Alexandr-Filatov/Storage_Armature_MCU_PCB/BOM/Storage_Armature_MCU_PCB_BOM_08.07.2026_EN.xlsx

Reference | Value | Product Name | Replacement | Package | Description | Quantity | DNP
C1, C2, C4, C6, C8, C9, C12, C13, C19, C22, C25, C28, C33, C37, C40, C43, C50, C54, C57, C59, C63, C65, C70, C75, C77, C81, C88, C90, C94, C97, C99, C103, C109, C110, C111, C112, C113 | 100n |  |  | SMD 0805 | Capacitor SMD 50V | 37
C48, C108 | 100n |  |  | SMD 1206 | Capacitor SMD 50V | 2
C3, C5, C7, C16, C31, C39, C49, C52, C53, C61, C62, C79, C80, C82, C83, C84, C85, C92, C93, C101, C102, C106 | 10n |  |  | SMD 0805 | Capacitor SMD 50V | 22
C34, C35, C44, C45, C47, C66, C74, C107 | 10u |  |  | SMD 1206 | Capacitor SMD 50V | 8
C26, C30 | 12p |  |  | SMD 0805 | Capacitor SMD 50V | 2
C15 | 1u |  |  | SMD 0805 | Capacitor SMD 50V | 1
C105 | 2.2n |  |  | SMD 1812 | Capacitor SMD 50V | 1
C18, C20, C21, C23, C24, C29, C32, C38, C42, C51, C56, C60, C72, C78, C87, C91, C96, C100 | 2.2u |  |  | SMD 0805 | Capacitor SMD 50V | 18
C17, C27, C36, C46, C58, C76, C89, C98 | 22n |  |  | SMD 0805 | Capacitor SMD 50V | 8
C67 | 330u | EEUFR1H331L |  | CP Radial D10.0mm P5.00mm | Polarized capacitor | 1
C14 | 4.7u |  |  | SMD 0805 | Capacitor SMD 50V | 1
C68, C69, C71, C73 | 4.7u |  |  | SMD 1206 | Capacitor SMD 50V | 4
C10, C11, C41, C55, C64, C86, C95, C104 | 56p |  |  | SMD 0805 | Capacitor SMD 50V | 8
D1 | ~ | B2405S-1WR3 |  | S-1WR3 | DC/DC | 1
D58, D61, D64, D67 | ~ | RS1B |  | SMA | Fast recovery diode | 4
D10 | ~ | SMCJ33A |  | SMC | Supressor | 1
D7, D17 | ~ | FYLS-0805UBC |  | SMD 0805 | Blue LED | 2
D11, D19, D22, D23, D57, D60, D63, D66, D68, D69, D70, D71 | ~ | FYLS-0805UYC |  | SMD 0805 | Yellow LED | 12
D24, D25, D26 | ~ | FYLS-1206UBC |  | SMD 1206 | Blue LED | 3
D20 | ~ | BZT52C10 |  | SOD-123 | Zener_Diode | 1
D5 | ~ | LBAT54HT1G |  | SOD-323 | Diode | 1
D14 | ~ | SM24CANB-02HTG |  | SOT-23 | Dual Line CAN Bus Protector, 24Vrwm | 1
D21 | ~ | SM712 |  | SOT-23 | ESD Diode | 1
D2, D3, D4, D6, D8, D13, D15, D16, D56, D59, D62, D65 | ~ | BAT54S |  | SOT-23 | Schottky barrier diode | 12
D18 | ~ | TD301D485H-A |  | TD301D485H-AB | RS485 Transciever | 1
D12 | ~ | TD301MCANFD |  | TD5(3)01MCANFD | CAN Transceiver | 1
D9 | ~ | WRB2405S-3WR2 |  | WRB S-3WR2 | DC/DC | 1
F1, F4, F5, F6 | ~ | MF-SM075/60-2 |  | Fuse Bourns MF-SM 7.98x5.44mm | Fuse SMD | 4
F3 | ~ | MF-MSMF020 |  | SMD 1812 | Fuse SMD | 1
F2 | ~ | MF-MSMF050/30X-2 |  | SMD 1812 | Fuse SMD | 1
J24, J25, J26, J27, J28, J29, J30, J31, J32, J33 | ~ | DS1073-01-2x1MR2T6 |  | Molex Mini-Fit Jr 5569-02A2 2x01 P4.20mm | Connector | 10
J6, J7, J8, J34, J35, J38, J39 | ~ | DS1073-01-2x2MR3T6 |  | Molex Mini-Fit Jr 5569-04A2 2x02 P4.20mm | Connector | 7
J2 | ~ | DS1073-01-2x3MR2T6 |  | Molex Mini-Fit Jr 5569-06A2 2x03 P4.20mm | Connector | 1
J1 | ~ | DS-1021-1x4 | KLS1-207-1-04-S | PinHeader 1x04 P2.54mm | Connector | 1
J3 | ~ | DS1021-2x8 | KLS1-207-2-16-S | PinHeader 2x08 P2.54mm | Connector | 1
JP1, JP2, JP3, JP4, JP5, JP6, JP7 | ~ | DS1027-2ABN0 |  | PinHeader 1x02 P2.54mm | Jumper | 7
L2, L3 | 6.8u | LQH32CN6R8M53L |  | SMD 1210 | Inductor SMD | 2
L1, L4 | ~ | ACM2520-301-2P-T002 |  | CommonModeChoke TDK ACM2520-2P | Inductor SMD | 2
Q10, Q11, Q12, Q13 | ~ | 2N7002 |  | SOT-23 | N_channel MOSFET | 4
Q1, Q2 | ~ | 20N06 |  | TO-252-2 | N_channel MOSFET | 2
R79, R80, R81, R82, R83, R84, R85, R86 | 0 |  |  | SMD 1206 | Resistor SMD 1% | 8
R3, R4, R18, R28, R36, R50, R62, R70 | 10 |  |  | SMD 1206 | Resistor SMD 0.1% | 8
R7, R9, R12, R13, R19, R20, R29, R30, R38, R41, R51, R52, R63, R64, R71, R72 | 100 |  |  | SMD 0805 | Resistor SMD 1% | 16
R55 | 100k |  |  | SMD 0805 | Resistor SMD 1% | 1
R1, R2, R8, R11, R14, R15, R23, R24, R31, R32, R42, R43, R53, R56, R65, R66, R73, R74, R90, R91, R93, R96, R97, R110, R113, R116, R119 | 10k |  |  | SMD 0805 | Resistor SMD 1% | 27
R10, R17, R27, R35, R46, R61, R69, R77 | 120 |  |  | SMD 0805 | Resistor SMD 1% | 8
R49 | 1M |  |  | SMD 2512 | Resistor SMD 1% | 1
R6, R39, R57, R58, R87, R108, R111, R114, R117, R120, R121, R122, R123 | 1k |  |  | SMD 0805 | Resistor SMD 1% | 13
R47, R48 | 20 |  |  | SMD 0805 | Resistor SMD 1% | 2
R5, R16, R21, R22, R25, R26, R33, R34, R44, R45, R59, R60, R67, R68, R75, R76 | 20k |  |  | SMD 0805 | Resistor SMD 1% | 16
R92, R94, R95 | 3.3k |  |  | SMD 1206 | Resistor SMD 1% | 3
R54, R109, R112, R115, R118 | 4.7k |  |  | SMD 0805 | Resistor SMD 1% | 5
R78 | 470k |  |  | SMD 0805 | Resistor SMD 1% | 1
R37, R40, R88, R89 | 59 |  |  | SMD 0805 | Resistor SMD 1% | 4
U23, U24, U25, U26 | ~ | RSCD06D3 |  | Finder 34.81 | Relay | 4
U1 | ~ | APM32F405RGT6 |  | LQFP-64 10x10mm P0.5mm | MCU | 1
U2, U3, U8, U10, U12, U15, U17, U19 | ~ | NSI1200 |  | SOIC-8 7.5x5.85mm P1.27mm | Digital Isolator | 8
U22 | ~ | LTV-247 |  | SOP-16 4.4x10.4mm P1.27mm | Photocoupler | 1
U4, U5 | ~ | ADP3338AKCZ-3.3RL7 |  | SOT-223-3 | Linear Regulator | 2
U6, U7, U9, U11, U13, U16, U18, U20 | ~ | OPA333 |  | SOT-23-5 | Op-Amp | 8
U14 | ~ | USBLC6-2SC6 |  | SOT-23-6 | ESD protection | 1
Y1 | 16M | X322516MOB4SI |  | Crystal SMD SeikoEpson FA238-4Pin 3.2x2.5mm | Crystal | 1
