Alexandr-Filatov/Storage_Armature_MCU_PCB/3D/TD301D485H-AB.stp

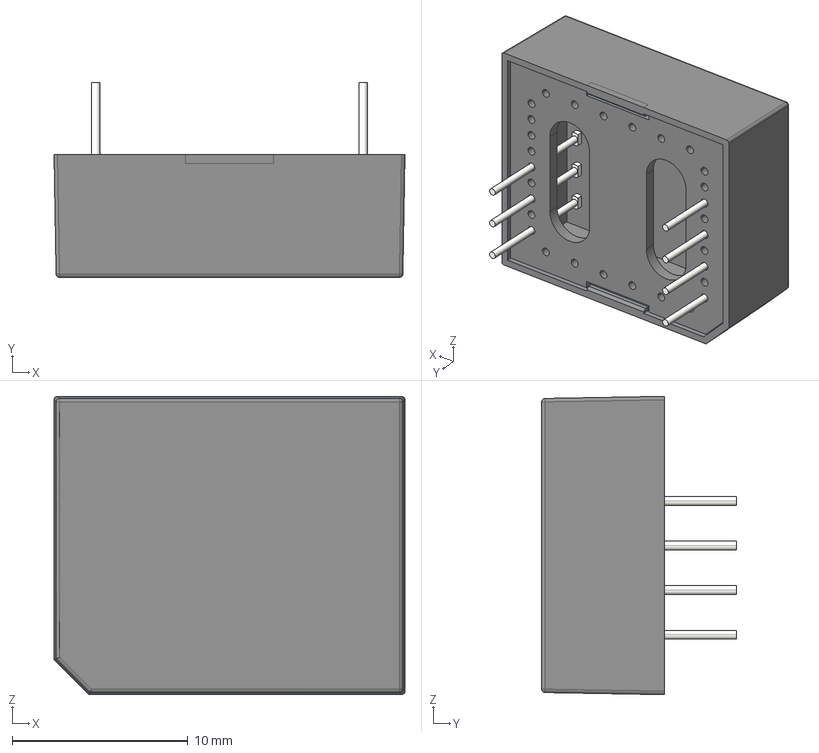
[picture p1: CAD file, 2026-05-08]
3D/TD301D485H-AB.stp
20.0 x 11.1 x 17.0 mm
MANIFOLD_SOLID_BREP_7983
MANIFOLD_SOLID_BREP_8387
MANIFOLD_SOLID_BREP_8791
MANIFOLD_SOLID_BREP_9195
MANIFOLD_SOLID_BREP_9599
MANIFOLD_SOLID_BREP_10003
MANIFOLD_SOLID_BREP_10407
MANIFOLD_SOLID_BREP_11215
