Alexandr-Filatov/Storage_Armature_MCU_PCB/3D/1812_V01.STEP

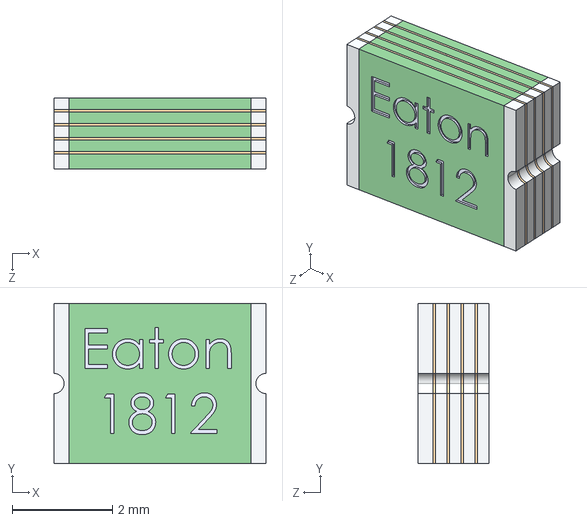
[picture p2: CAD file, 2026-05-06]
3D/1812_V01.STEP
4.23 x 3.20 x 1.42 mm
