Alexandr-Filatov/Storage_Armature_MCU_PCB/3D/MF-SM075-2.stp

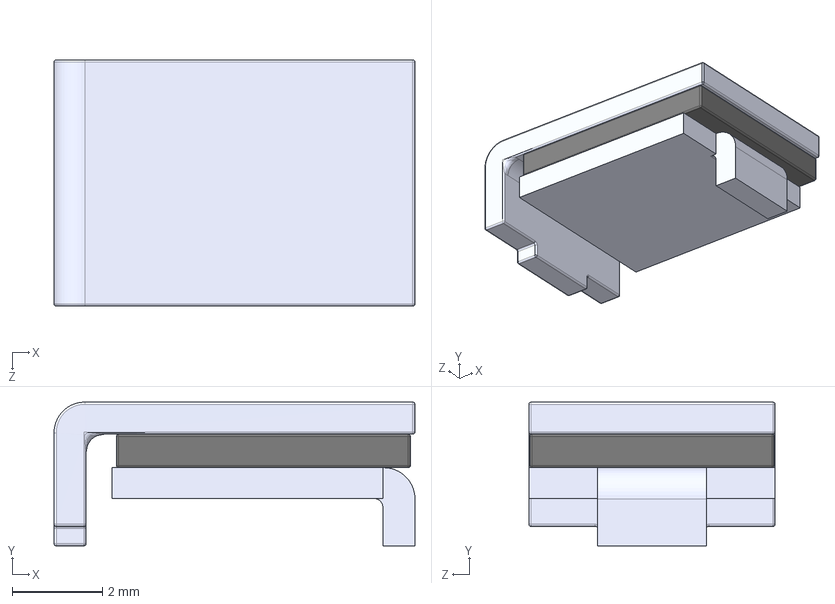
[picture p3: CAD file, 2026-05-05]
3D/MF-SM075-2.stp
7.98 x 3.18 x 5.44 mm
