Alexandr-Filatov/Storage_Armature_MCU_PCB/3D/B_LS-1WR3.stp

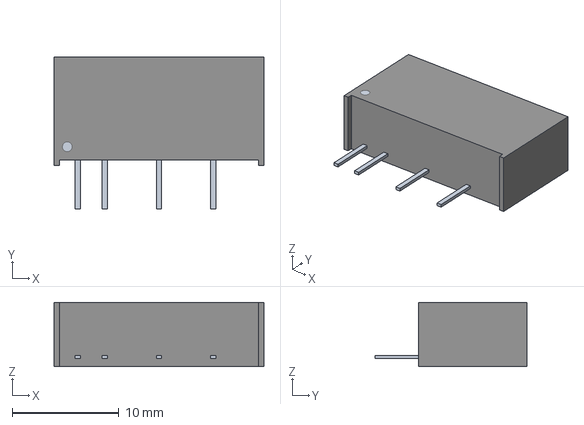
[picture p4: CAD file, 2026-05-04]
3D/B_LS-1WR3.stp
19.6 x 14.3 x 6.00 mm
