Alexandr-Filatov/Storage_Armature_MCU_PCB/3D/B_S-2WR3.stp

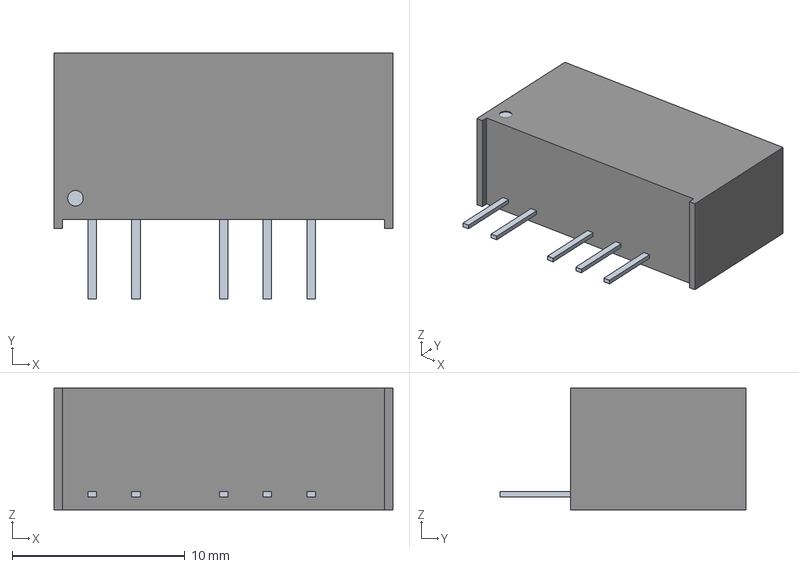
[picture p6: CAD file, 2026-04-29]
3D/B_S-2WR3.stp
19.6 x 14.3 x 7.05 mm
