Alexandr-Filatov/Storage_Armature_MCU_PCB/3D/FL2D-30-103.stp

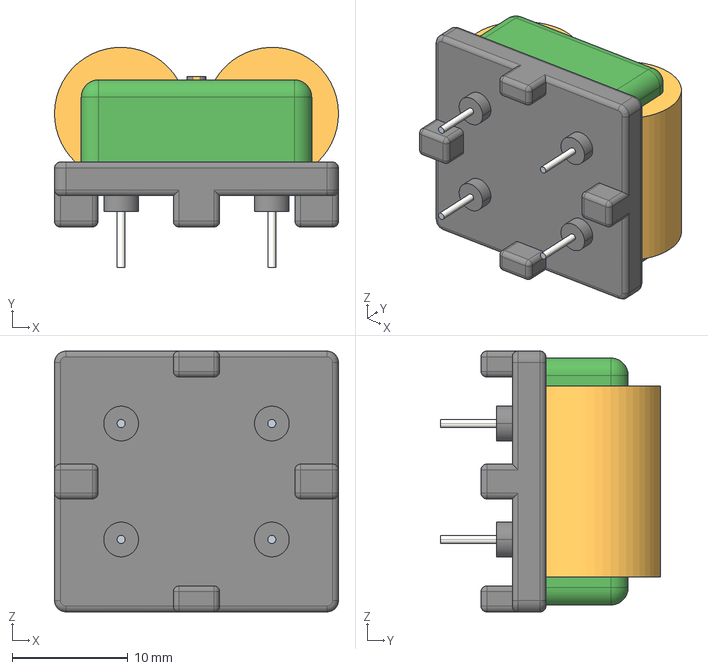
[picture p8: CAD file, 2026-04-29]
3D/FL2D-30-103.stp
24.5 x 19.0 x 22.5 mm
