Alexandr-Filatov/Storage_Armature_MCU_PCB/3D/SMD Fuse SF-2410SP.stp

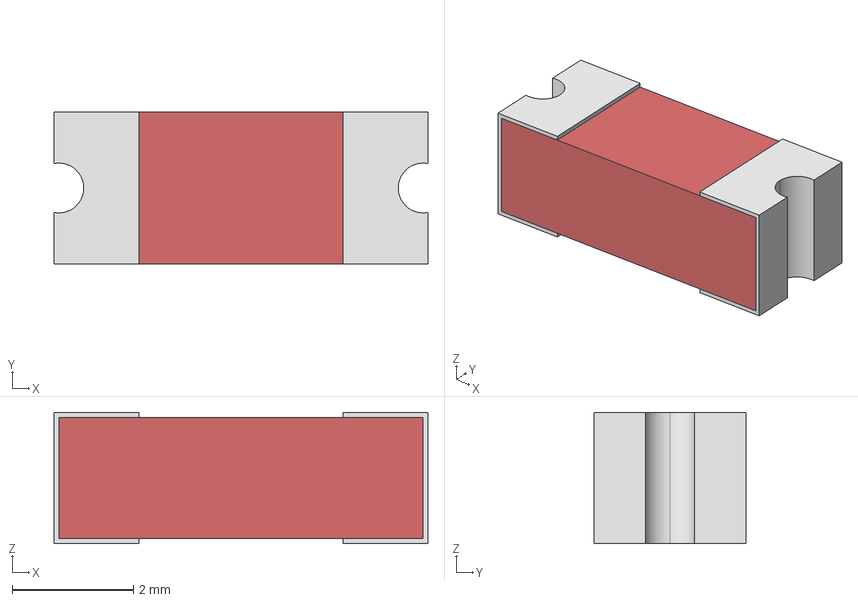
[picture p9: CAD file, 2026-04-29]
3D/SMD Fuse SF-2410SP.stp
6.16 x 2.50 x 2.16 mm
