Alexandr-Filatov/Storage_Armature_MCU_PCB/3D/URA_ZP-10WR3.stp

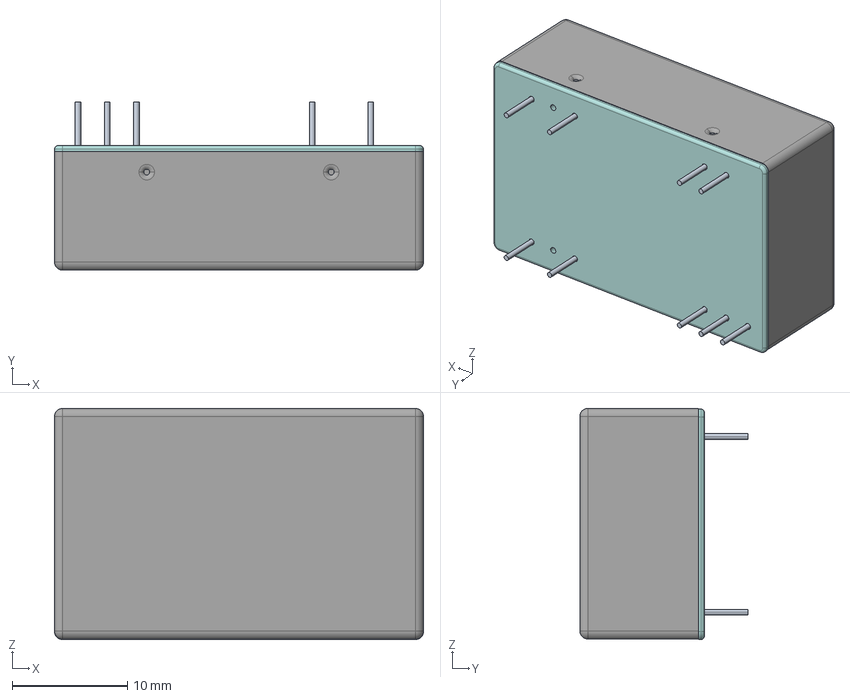
[picture p10: CAD file, 2026-04-29]
3D/URA_ZP-10WR3.stp
32.0 x 14.6 x 20.1 mm
SHE11_32X20_15_1_1
BASE_32X20_79_1_1
