Alexandr-Filatov/Storage_Armature_MCU_PCB/3D/NSI1311.stp

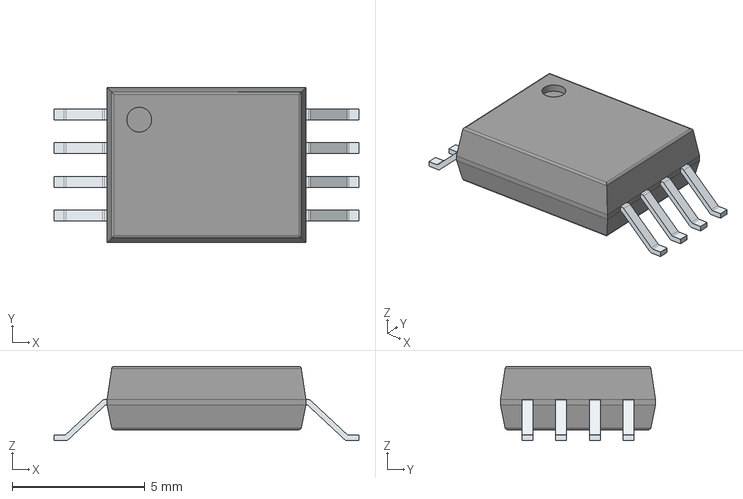
[picture p11: CAD file, 2026-04-29]
3D/NSI1311.stp
11.5 x 5.85 x 2.80 mm
PinsArrayLR
