Alexandr-Filatov/Storage_Armature_MCU_PCB/3D/TD5(3)01MCAN.stp

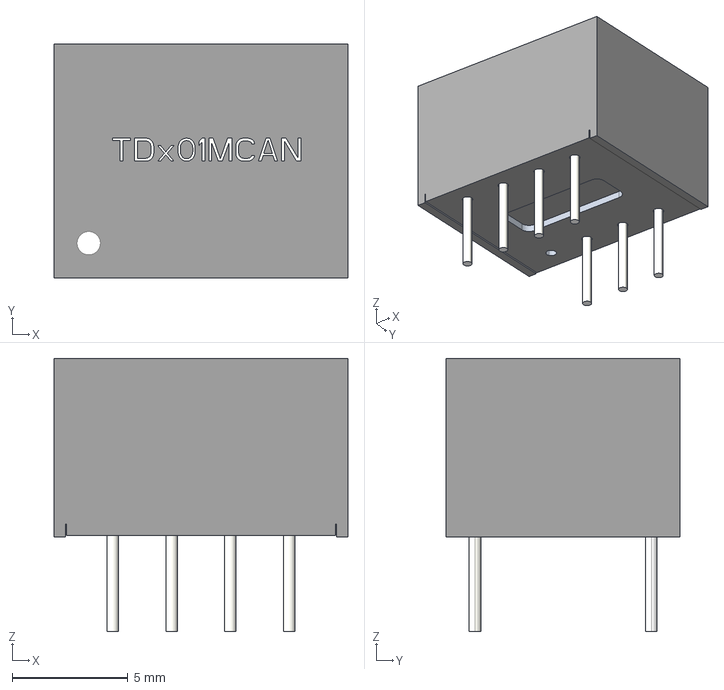
[picture p13: CAD file, 2026-04-29]
3D/TD5(3)01MCAN.stp
12.7 x 10.1 x 11.8 mm
