Alexandr-Filatov/Storage_Armature_MCU_PCB/3D/IND_DLW5BS_2020_MUR.step

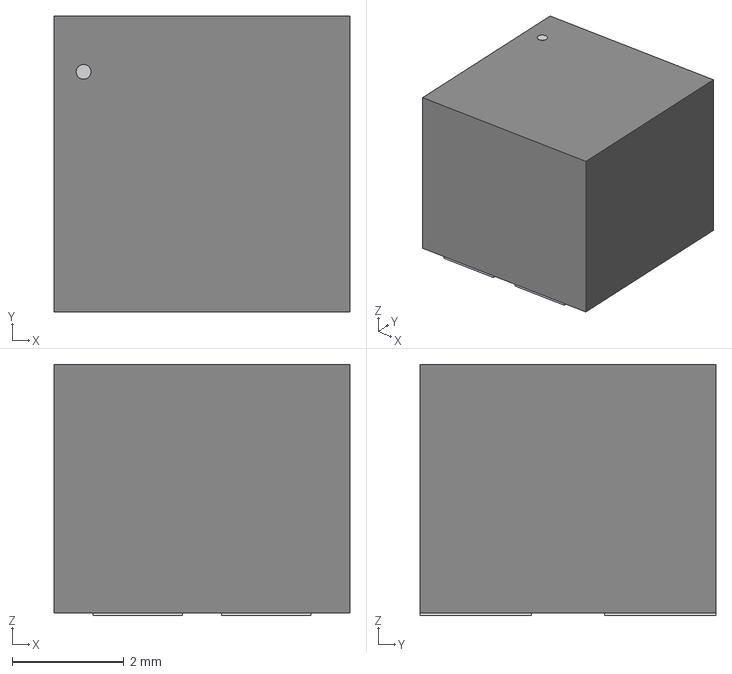
[picture p14: CAD file, 2026-04-29]
3D/IND_DLW5BS_2020_MUR.step
5.30 x 5.30 x 4.50 mm
