Alexandr-Filatov/Storage_Armature_MCU_PCB/3D/Tyco KiloVac EV200 Contactor.STEP

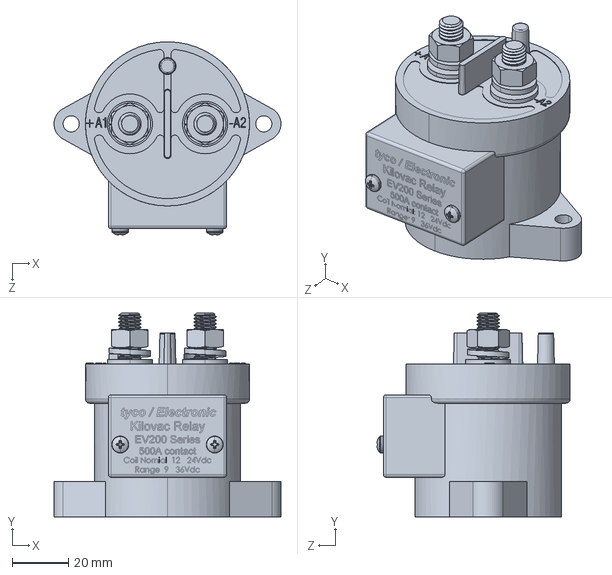
[picture p15: CAD file, 2026-04-29]
3D/Tyco KiloVac EV200 Contactor.STEP
80.5 x 72.3 x 68.6 mm
