Alexandr-Filatov/Storage_Armature_MCU_PCB/3D/0353180620.stp

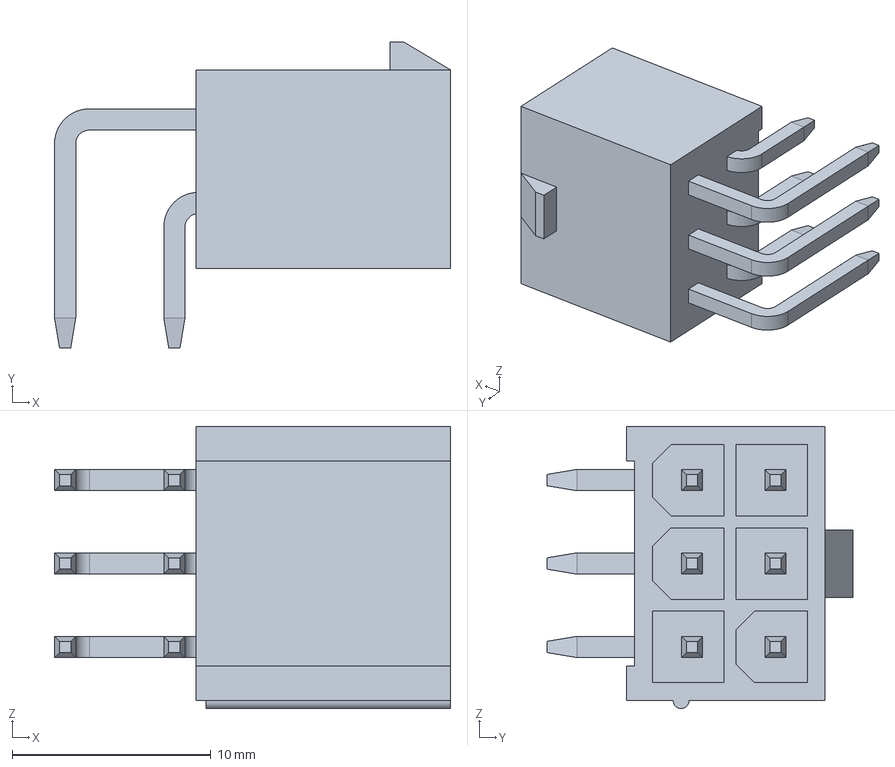
[picture p16: CAD file, 2026-05-25]
3D/0353180620.stp
19.9 x 15.4 x 14.2 mm
