Alexandr-Filatov/Storage_Armature_MCU_PCB/3D/0026013114.stp

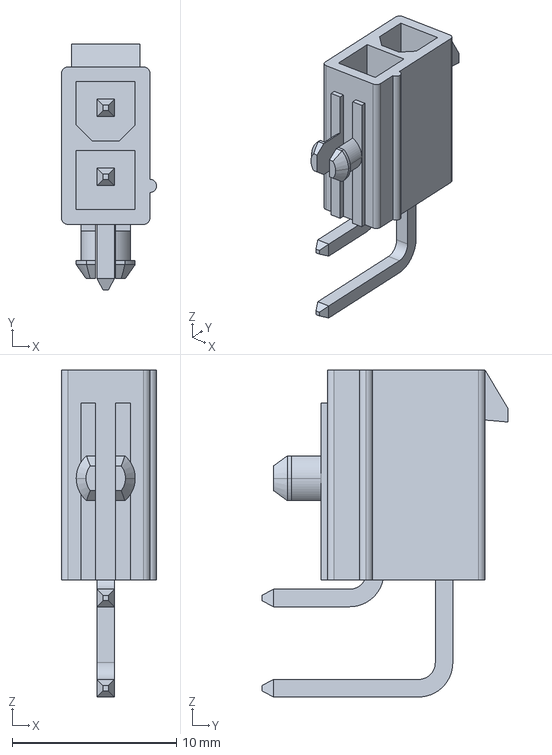
[picture p17: CAD file, 2026-05-04]
3D/0026013114.stp
5.80 x 15.0 x 19.9 mm
