Alexandr-Filatov/Storage_Armature_MCU_PCB/(list of files, cad)

Other CAD files:
3D/1-776087-1.step
3D/0039281063.stp
3D/0039288040.stp
3D/0300700235.stp
3D/0353180420.stp
3D/039288020.stp
3D/2071583-4.stp
