Alexandr-Filatov/Storage_Armature_MCU_PCB/Docs/Reporting Docs/Монтажная схема платы КВУ верхний слой.pdf

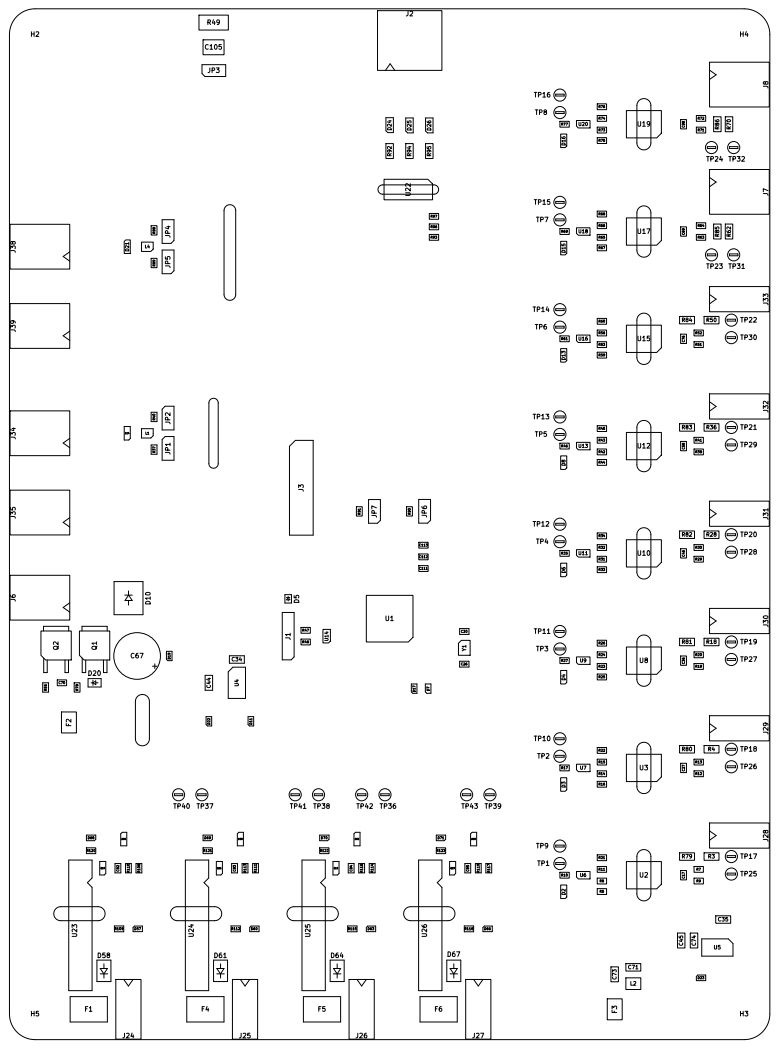
[picture p18: page 1]

Size: A2 | Rev:
KiCad E.D.A. 10.0.1 | Id: 1/1
