Alexandr-Filatov/Storage_Armature_MCU_PCB/Docs/Reporting Docs/Плата КВУ схема Э3.pdf

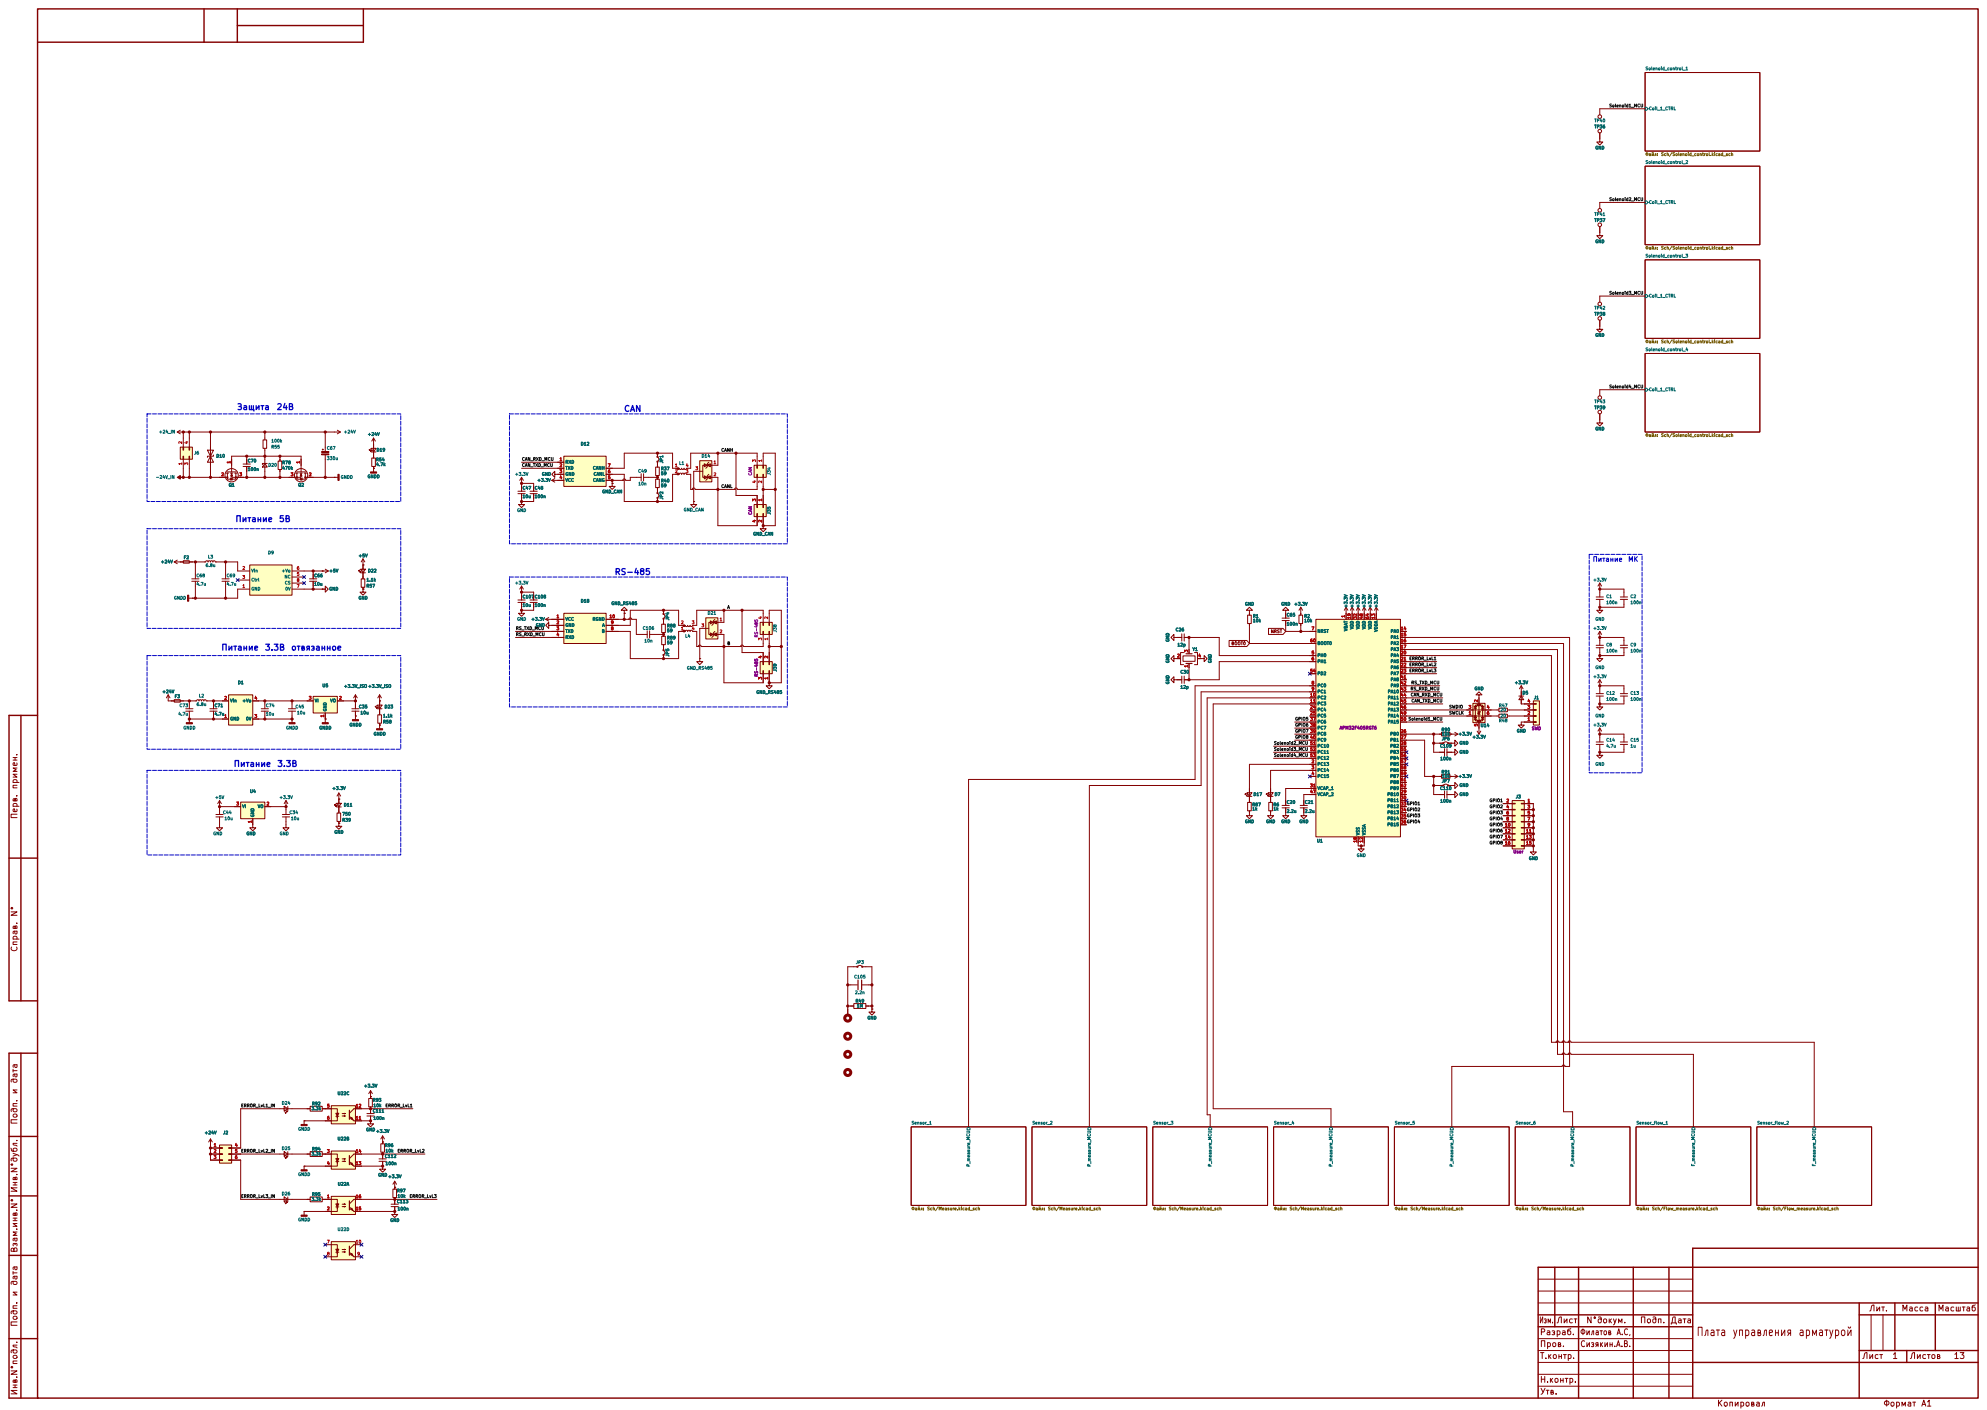
[picture p20: page 1]

Н.контр. Перв. примен. Подп. и дата Подп. и дата

Пров.
Т.контр.

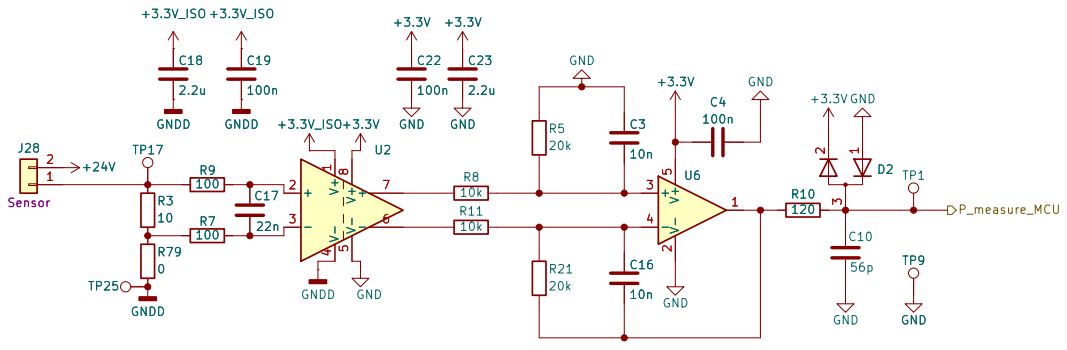
[picture p21: page 2]

Лист Подп. и дата Подп. и дата

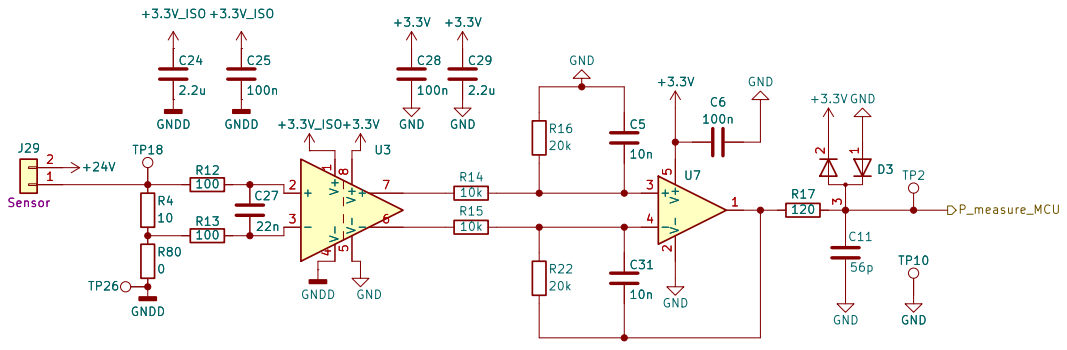
[picture p22: page 3]

Лист Подп. и дата Подп. и дата

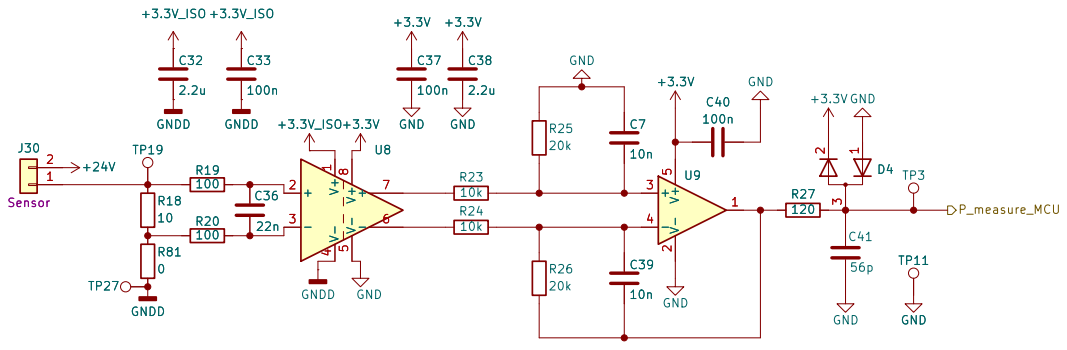
[picture p23: page 4]

Лист Подп. и дата Подп. и дата

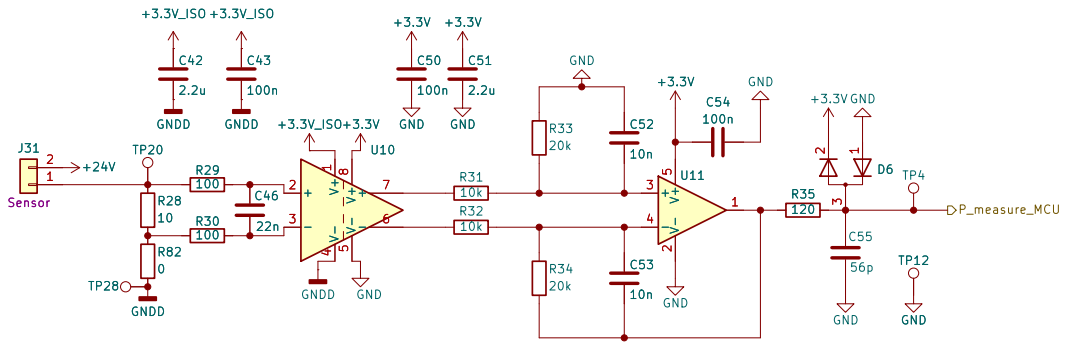
[picture p24: page 5]

Лист Подп. и дата Подп. и дата

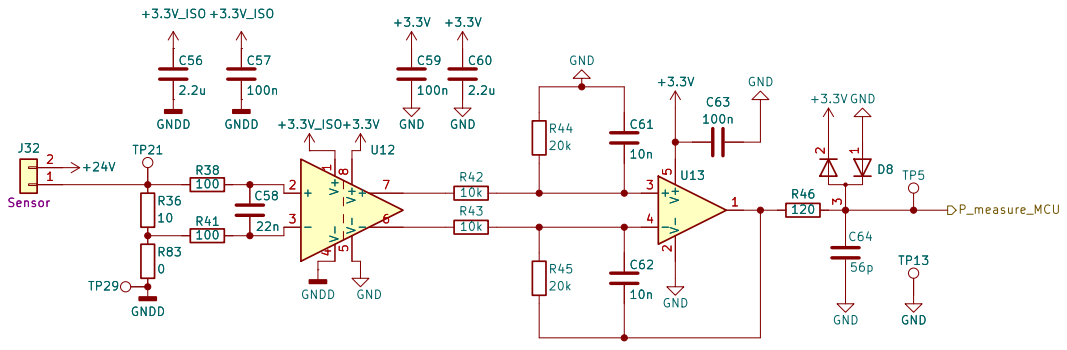
[picture p25: page 6]

Лист Подп. и дата Подп. и дата

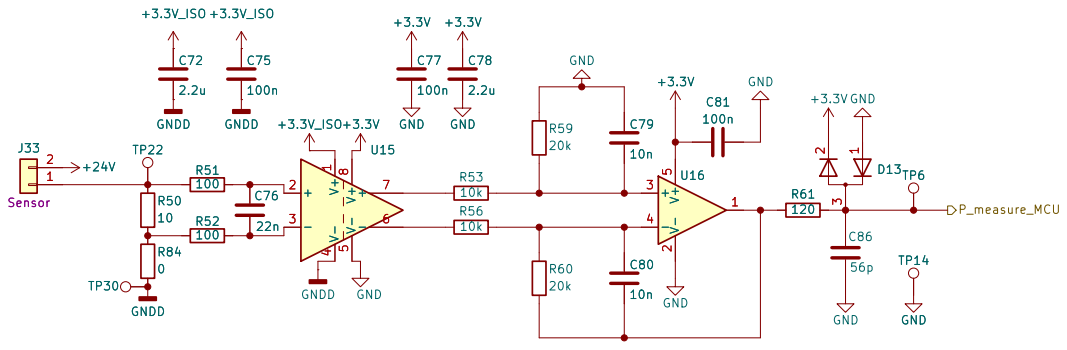
[picture p26: page 7]

Лист Подп. и дата Подп. и дата

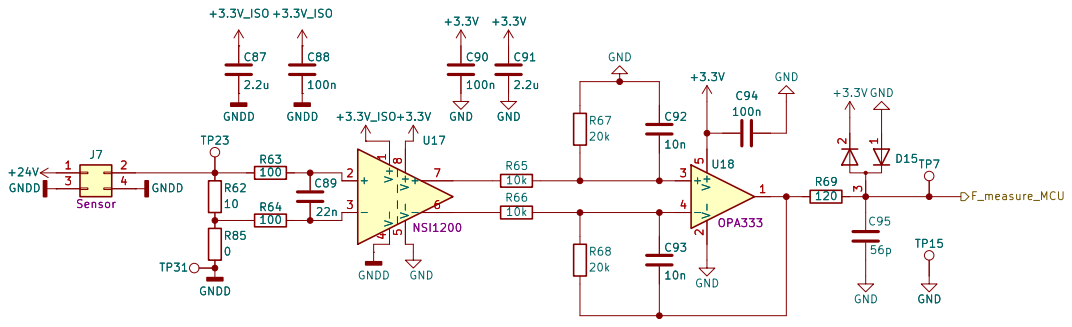
[picture p27: page 8]

Лист Подп. и дата Подп. и дата

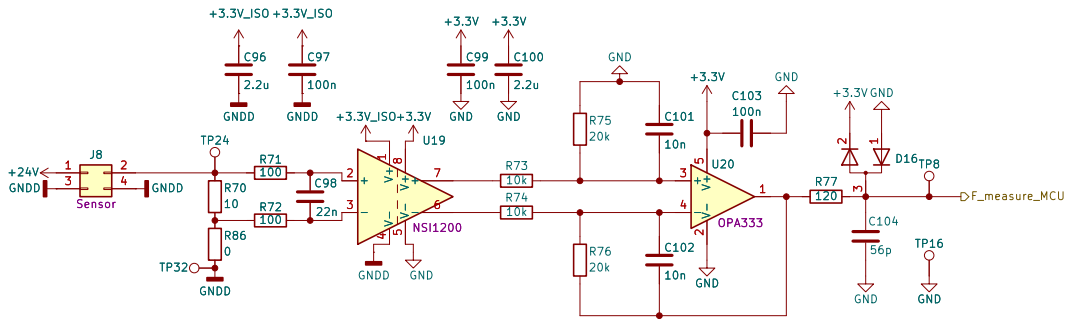
[picture p28: page 9]

Лист Подп. и дата Подп. и дата

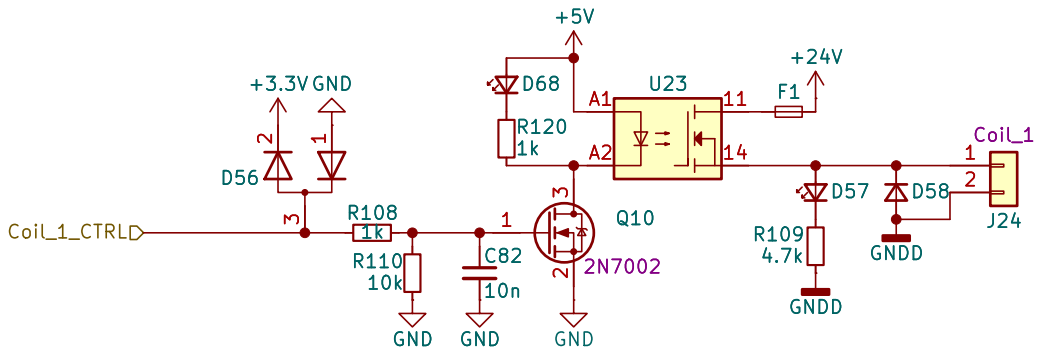
[picture p29: page 10]

Лист Подп. и дата Подп. и дата

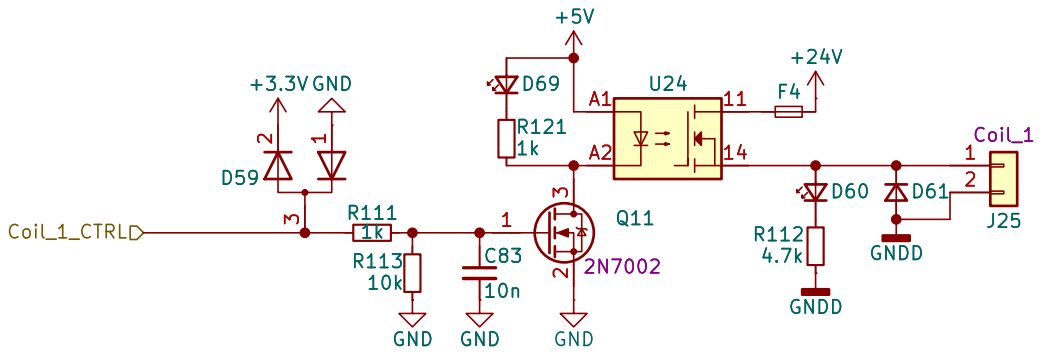
[picture p30: page 11]

Лист Подп. и дата Подп. и дата

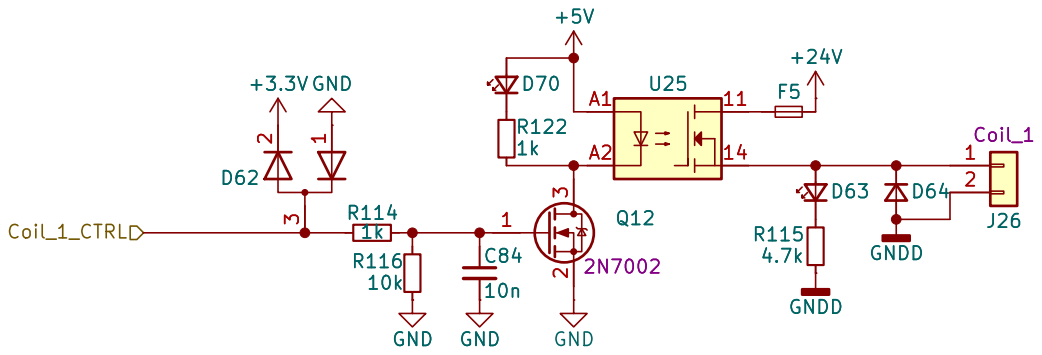
[picture p31: page 12]

Лист Подп. и дата Подп. и дата

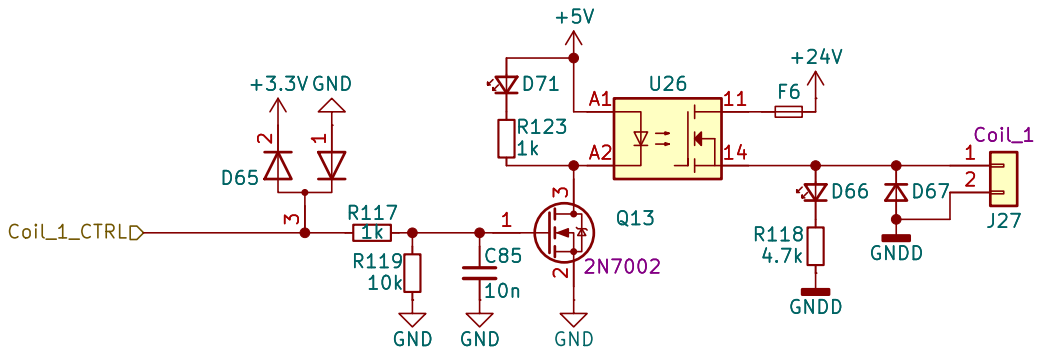
[picture p32: page 13]

Лист Подп. и дата Подп. и дата
