Alexandr-Filatov/Storage_Armature_MCU_PCB/Docs/Storage_Armature_MCU_PCB.pdf

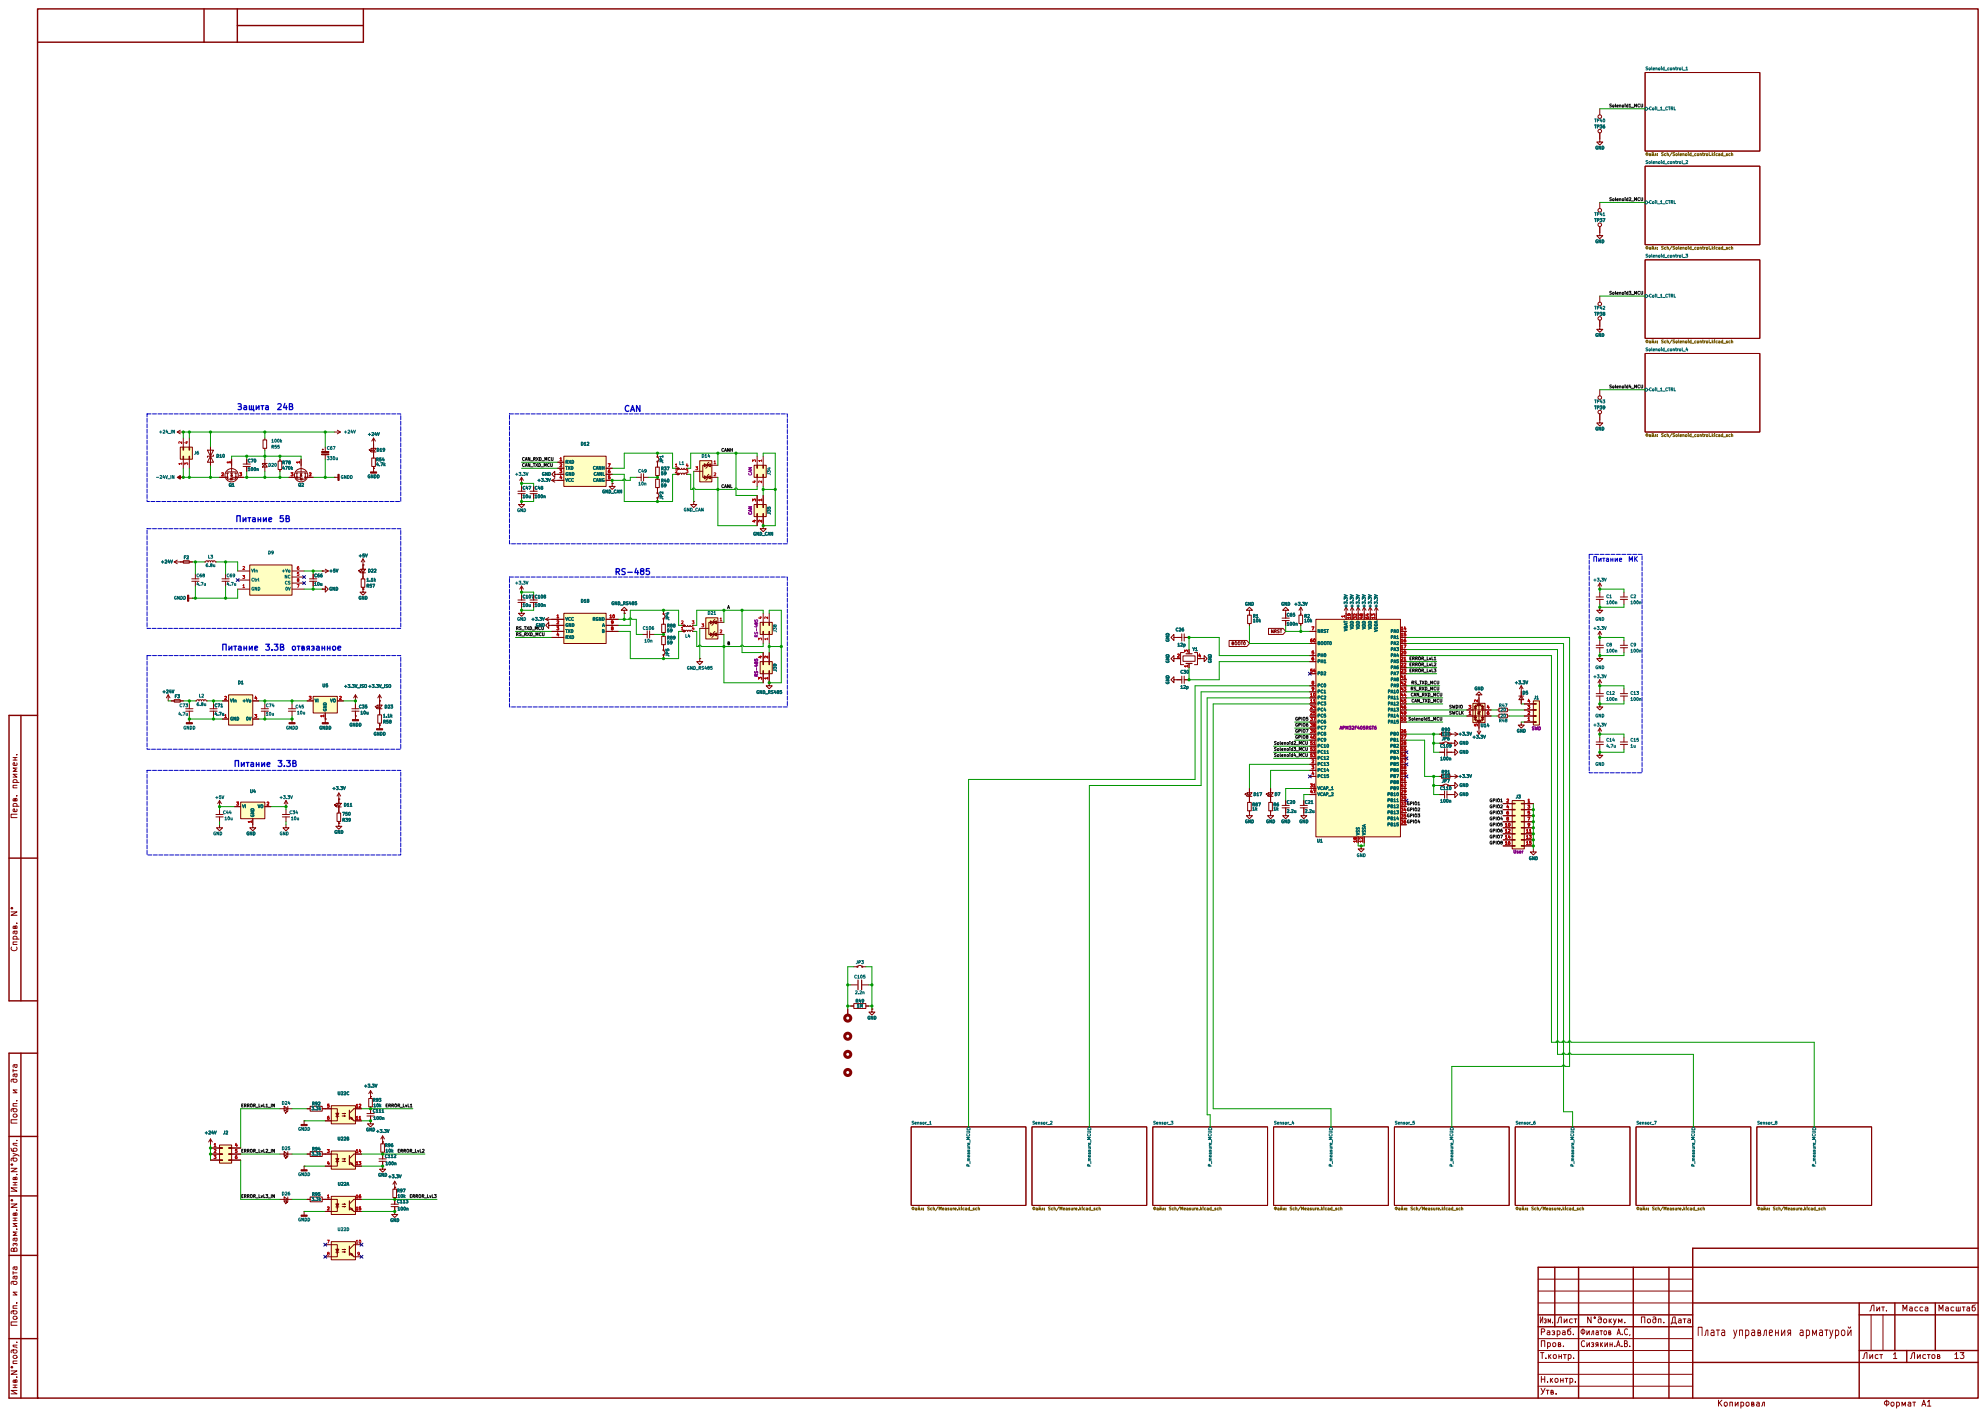
[picture p33: page 1]

Н.контр. Перв. примен. Подп. и дата Подп. и дата

Пров.
Т.контр.

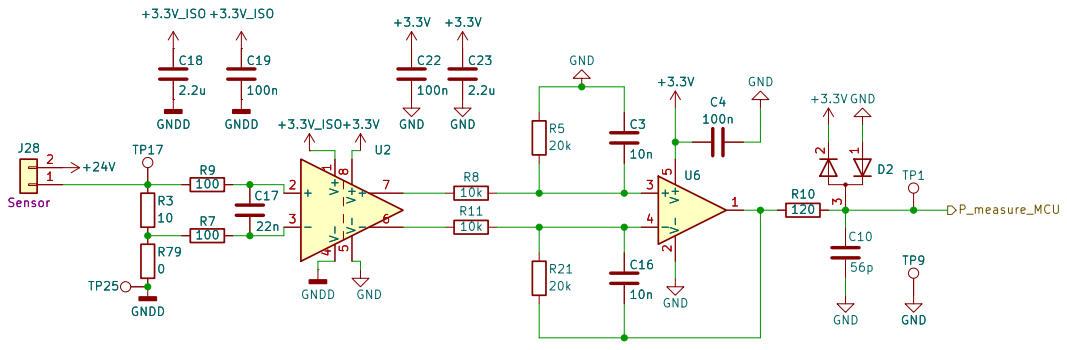
[picture p34: page 2]

Лист Подп. и дата Подп. и дата

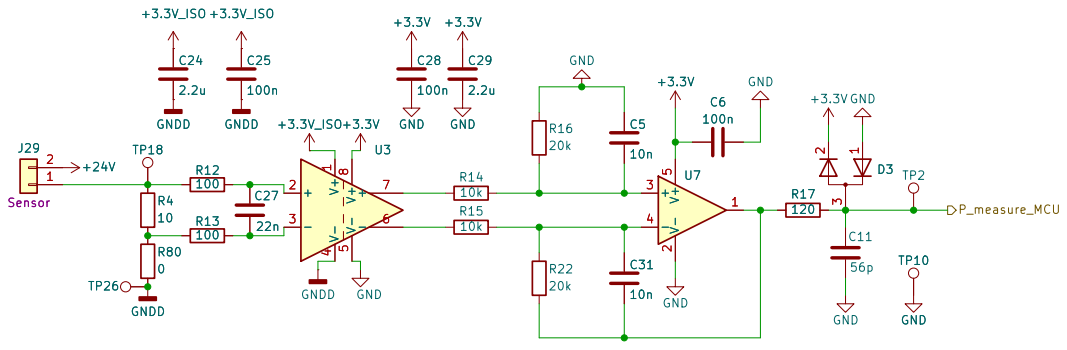
[picture p35: page 3]

Лист Подп. и дата Подп. и дата

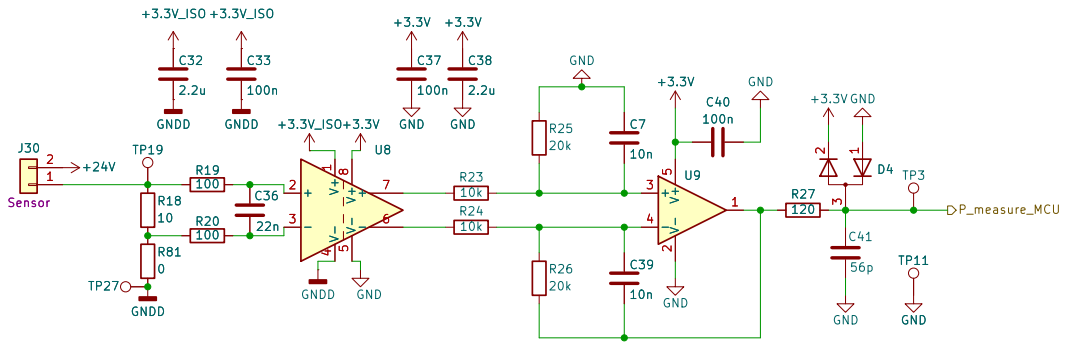
[picture p36: page 4]

Лист Подп. и дата Подп. и дата

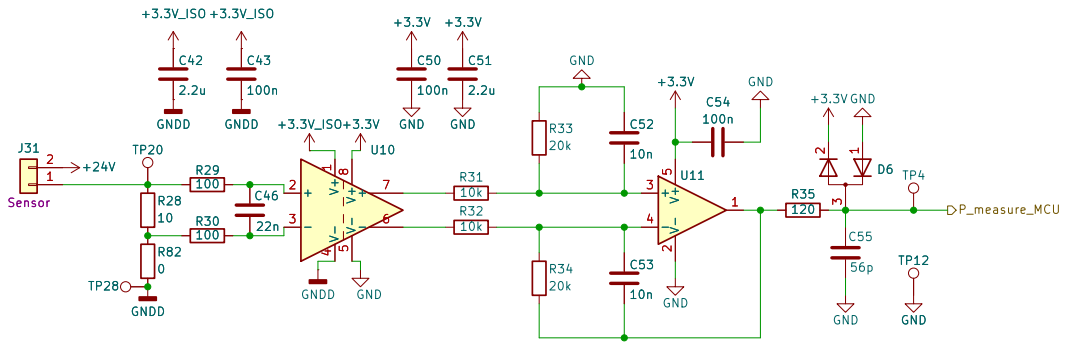
[picture p37: page 5]

Лист Подп. и дата Подп. и дата

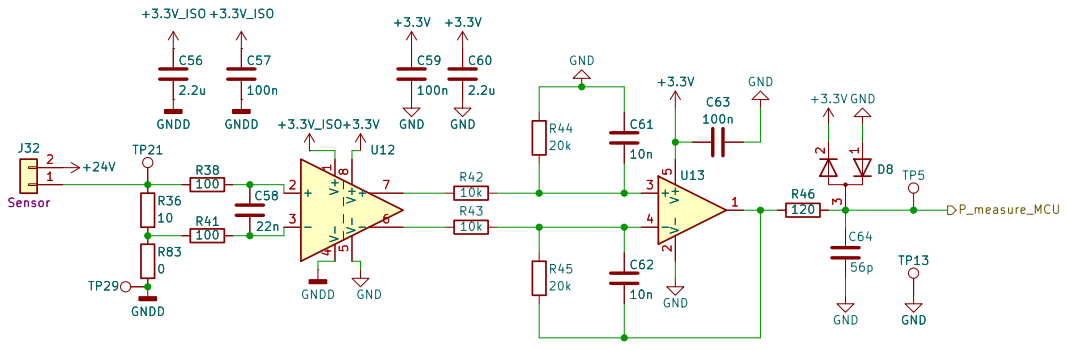
[picture p38: page 6]

Лист Подп. и дата Подп. и дата

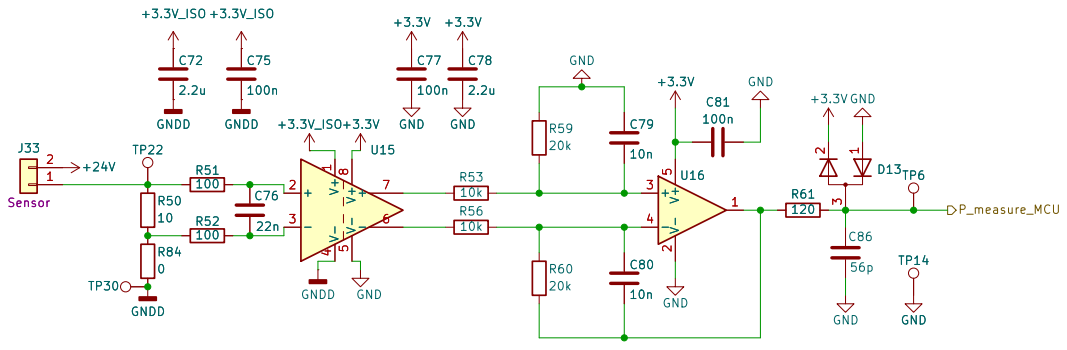
[picture p39: page 7]

Лист Подп. и дата Подп. и дата

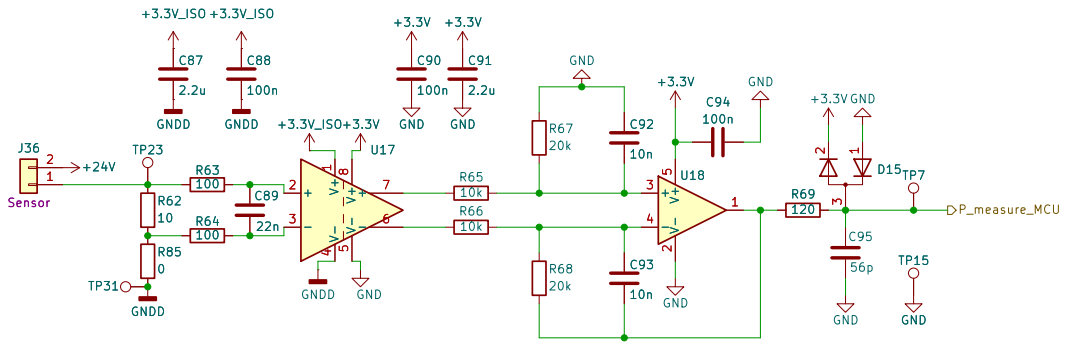
[picture p40: page 8]

Лист Подп. и дата Подп. и дата

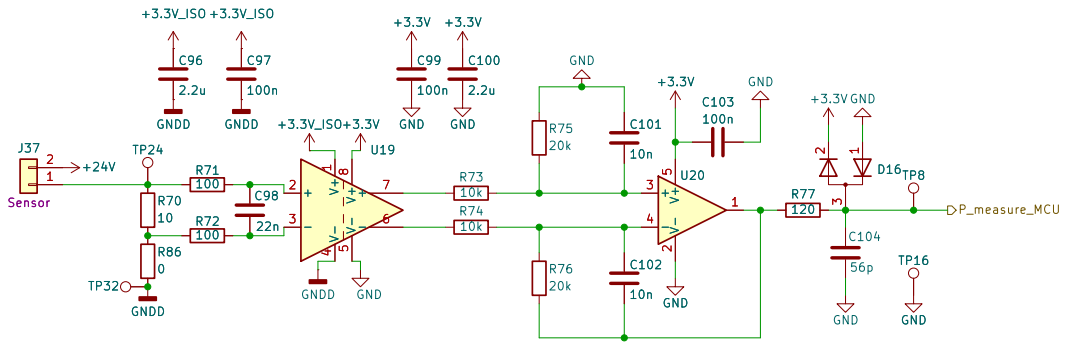
[picture p41: page 9]

Лист Подп. и дата Подп. и дата

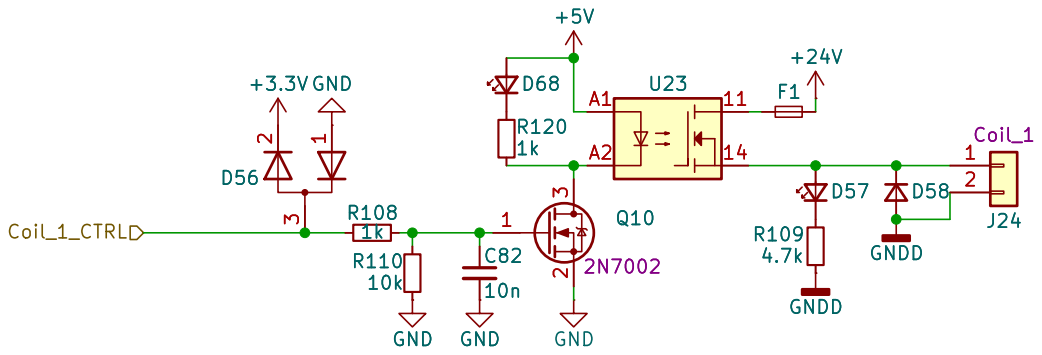
[picture p42: page 10]

Лист Подп. и дата Подп. и дата

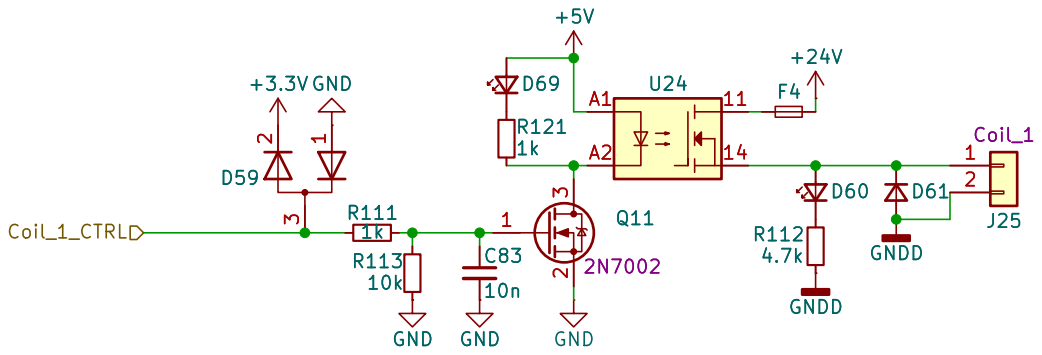
[picture p43: page 11]

Лист Подп. и дата Подп. и дата

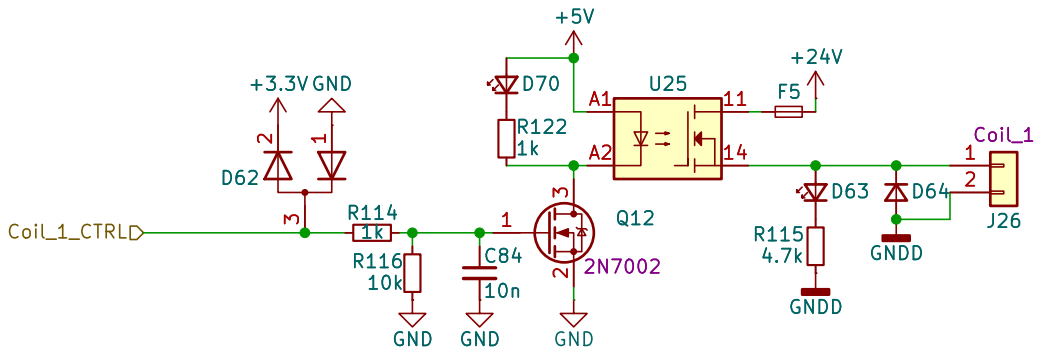
[picture p44: page 12]

Лист Подп. и дата Подп. и дата

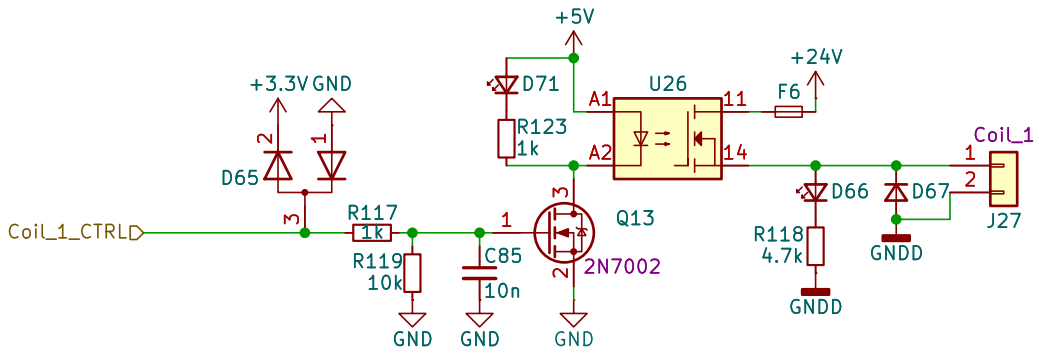
[picture p45: page 13]

Лист Подп. и дата Подп. и дата
