Alexandr-Filatov/Storage_Armature_MCU_PCB/(list of files, drawings)

Other design files:
3D/WRB_S-3WR2.PcbLib
3D/WRB_S-3WR2.SchLib
