Alexandr-Filatov/Storage_Armature_MCU_PCB/Storage_Armature_MCU_PCB.kicad_pcb

## KiCad design Storage_Armature_MCU_PCB.kicad_pcb (2026-07-08)

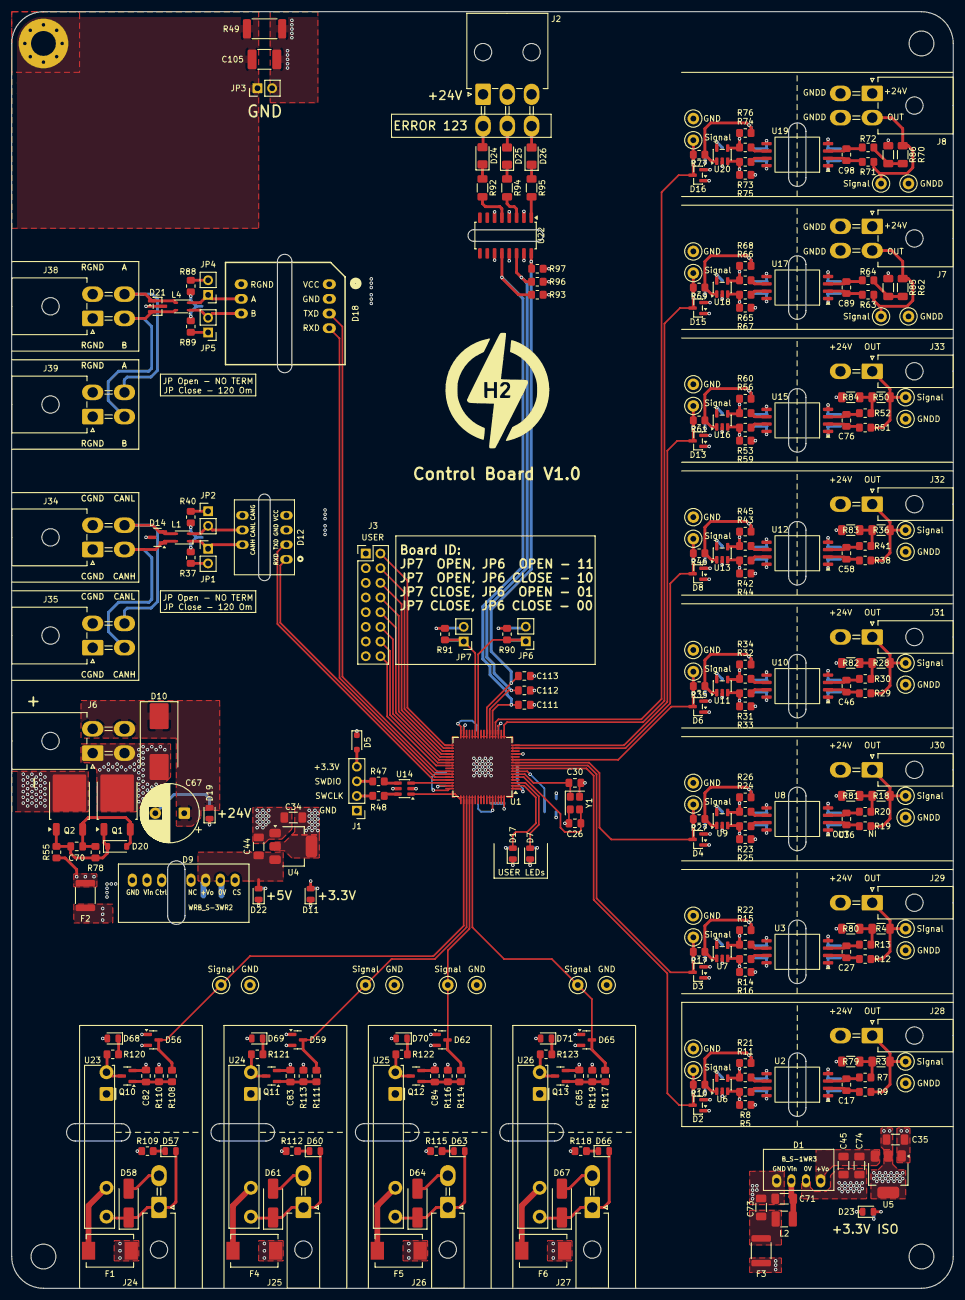
[picture p46: board Storage_Armature_MCU_PCB.kicad_pcb from above]

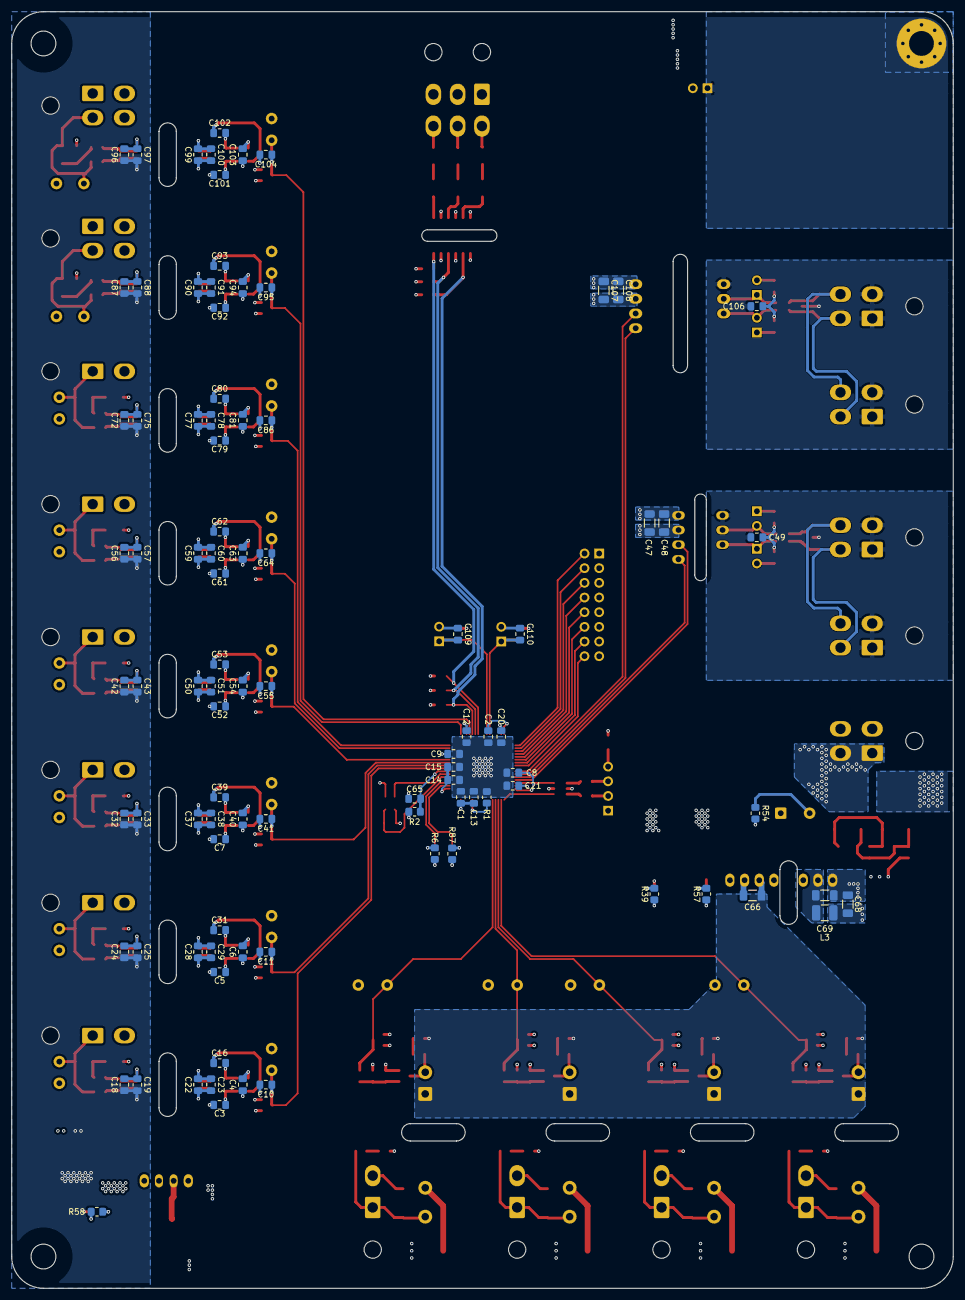
[picture p47: board Storage_Armature_MCU_PCB.kicad_pcb from below]

Board: 4 copper layers, 163.0 x 221.0 mm, 381 parts (95 on the bottom side), 186 nets.

Parts:
C1, C2, C4, C6, C8, C9, C12, C13, C19, C22, C25, C28, C33, C37, C40, C43, C50, C54, C57, C59, C63, C65, C70, C75, C77, C81, C88, C90, C94, C97, C99, C103, C109, C110, C111, C112, C113: 100n; C_0805_2012Metric_Pad1.18x1.45mm_HandSolder
C3, C5, C7, C16, C31, C39, C49, C52, C53, C61, C62, C79, C80, C82, C83, C84, C85, C92, C93, C101, C102, C106: 10n; C_0805_2012Metric_Pad1.18x1.45mm_HandSolder
C10, C11, C41, C55, C64, C86, C95, C104: 56p; C_0805_2012Metric_Pad1.18x1.45mm_HandSolder
C14: 4.7u; C_0805_2012Metric_Pad1.18x1.45mm_HandSolder
C15: 1u; C_0805_2012Metric_Pad1.18x1.45mm_HandSolder
C17, C27, C36, C46, C58, C76, C89, C98: 22n; C_0805_2012Metric_Pad1.18x1.45mm_HandSolder
C18, C20, C21, C23, C24, C29, C32, C38, C42, C51, C56, C60, C72, C78, C87, C91, C96, C100: 2.2u; C_0805_2012Metric_Pad1.18x1.45mm_HandSolder
C26, C30: 12p; C_0805_2012Metric_Pad1.18x1.45mm_HandSolder
C34, C35, C44, C45, C47, C66, C74, C107: 10u; C_1206_3216Metric_Pad1.33x1.80mm_HandSolder
C48, C108: 100n; C_1206_3216Metric_Pad1.33x1.80mm_HandSolder
C67: 330u; CP_Radial_D10.0mm_P5.00mm
C68, C69, C71, C73: 4.7u; C_1206_3216Metric_Pad1.33x1.80mm_HandSolder
C105: 2.2n; C_1812_4532Metric_Pad1.57x3.40mm_HandSolder
D1: B_S-1WR3
D2, D3, D4, D6, D8, D13, D14, D15, D16, D21, D56, D59, D62, D65: SOT-23
D5: D_SOD-323_HandSoldering
D7, D11, D17, D19, D22, D23, D57, D60, D63, D66, D68, D69, D70, D71: LED_0805_2012Metric
D9: WRB_S-3WR2
D10: D_SMC_Handsoldering
D12: TD5(3)01MCANFD
D18: TD301D485H-AB
D20: D_SOD-123
D24, D25, D26: LED_1206_3216Metric_Pad1.42x1.75mm_HandSolder
D58, D61, D64, D67: D_SMA_Handsoldering
F1, F4, F5, F6: Fuse_Bourns_MF-SM_7.98x5.44mm
F2, F3: Fuse_1812_4532Metric
H2: MountingHole_Pad; MountingHole_4.3mm_M4_Pad_Via
H3, H4, H5: MountingHole; MountingHole_4.3mm_M4
J1: PinHeader_1x04_P2.54mm_Vertical
J2: Molex_Mini-Fit_Jr_5569-06A2_2x03_P4.20mm_Horizontal
J3: PinHeader_2x08_P2.54mm_Vertical
J6, J7, J8, J34, J35, J38, J39: Molex_Mini-Fit_Jr_5569-04A2_2x02_P4.20mm_Horizontal
J24, J25, J26, J27, J28, J29, J30, J31, J32, J33: Molex_Mini-Fit_Jr_5569-02A2_2x01_P4.20mm_Horizontal
JP1, JP2, JP3, JP4, JP5, JP6, JP7: PinHeader_1x02_P2.54mm_Vertical
L1, L4: L_CommonModeChoke_TDK_ACM2520-2P
L2, L3: 6.8u; L_1210_3225Metric_Pad1.42x2.65mm_HandSolder
Q1, Q2: TO-252-2
Q10, Q11, Q12, Q13: SOT-23
R1, R2, R8, R11, R14, R15, R23, R24, R31, R32, R42, R43, R53, R56, R65, R66, R73, R74, R90, R91, R93, R96, R97, R110, R113, R116, R119: 10k; R_0805_2012Metric_Pad1.20x1.40mm_HandSolder
R3, R4, R18, R28, R36, R50, R62, R70: 10; R_1206_3216Metric_Pad1.30x1.75mm_HandSolder
R5, R16, R21, R22, R25, R26, R33, R34, R44, R45, R59, R60, R67, R68, R75, R76: 20k; R_0805_2012Metric_Pad1.20x1.40mm_HandSolder
R6, R39, R57, R58, R87, R108, R111, R114, R117, R120, R121, R122, R123: 1k; R_0805_2012Metric_Pad1.20x1.40mm_HandSolder
R7, R9, R12, R13, R19, R20, R29, R30, R38, R41, R51, R52, R63, R64, R71, R72: 100; R_0805_2012Metric_Pad1.20x1.40mm_HandSolder
R10, R17, R27, R35, R46, R61, R69, R77: 120; R_0805_2012Metric_Pad1.20x1.40mm_HandSolder
R37, R40, R88, R89: 59; R_0805_2012Metric_Pad1.20x1.40mm_HandSolder
R47, R48: 20; R_0805_2012Metric_Pad1.20x1.40mm_HandSolder
R49: 1M; R_2512_6332Metric_Pad1.40x3.35mm_HandSolder
R54, R109, R112, R115, R118: 4.7k; R_0805_2012Metric_Pad1.20x1.40mm_HandSolder
R55: 100k; R_0805_2012Metric_Pad1.20x1.40mm_HandSolder
R78: 470k; R_0805_2012Metric_Pad1.20x1.40mm_HandSolder
R79, R80, R81, R82, R83, R84, R85, R86: 0; R_1206_3216Metric_Pad1.30x1.75mm_HandSolder
R92, R94, R95: 3.3k; R_1206_3216Metric_Pad1.30x1.75mm_HandSolder
TP1, TP2, TP3, TP4, TP5, TP6, TP7, TP8, TP9, TP10, TP11, TP12, TP13, TP14, TP15, TP16, TP17, TP18, TP19, TP20, TP21, TP22, TP23, TP24, TP25, TP26, TP27, TP28, TP29, TP30, TP31, TP32, TP36, TP37, TP38, TP39, TP40, TP41, TP42, TP43: TestPoint; TestPoint_Loop_D1.80mm_Drill1.0mm_Beaded
U1: LQFP-64_10x10mm_P0.5mm
U2, U3, U8, U10, U12, U15, U17, U19: SOIC-8_7.5x5.85mm_P1.27mm
U4, U5: SOT-223-3_TabPin2
U6, U7, U9, U11, U13, U16, U18, U20: SOT-23-5
U14: SOT-23-6
U22: SOP-16_4.4x10.4mm_P1.27mm
U23, U24, U25, U26: Finder_34.81
Y1: 16M; Crystal_SMD_SeikoEpson_FA238-4Pin_3.2x2.5mm

Connections:
+3.3V: C1.1, C2.1, C4.1, C6.1, C8.1, C9.1, C12.1, C13.1, C14.1, C15.1, C22.1, C23.1, C28.1, C29.1, C34.2, C37.1, C38.1, C40.1, C47.1, C48.1, C50.1, C51.1, C54.1, C59.1, C60.1, C63.1, C77.1, C78.1, C81.1, C90.1, C91.1, C94.1, C99.1, C100.1, C103.1, C107.1, C108.1, D2.2 (K), D3.2 (K), D4.2 (K), D5.1 (K), D6.2 (K), D8.2 (K), D11.2 (A), D12.4 (VCC), D13.2 (K), D15.2 (K), D16.2 (K), D18.1 (VCC), D56.2 (K), D59.2 (K), D62.2 (K), D65.2 (K), R2.1, R90.1, R91.1, R93.2, R96.2, R97.2, U1.1 (VBAT), U1.13 (VDDA), U1.19 (VDD), U1.32 (VDD), U1.48 (VDD), U1.64 (VDD), U2.8 (V+), U3.8 (V+), U4.2 (VO), U6.5 (V+), U7.5 (V+), U8.8 (V+), U9.5 (V+), U10.8 (V+), U11.5 (V+), U12.8 (V+), U13.5 (V+), U14.5 (VBUS), U15.8 (V+), U16.5 (V+), U17.8 (V+), U18.5 (V+), U19.8 (V+), U20.5 (V+)
+3.3V_ISO: C18.1, C19.1, C24.1, C25.1, C32.1, C33.1, C35.2, C42.1, C43.1, C56.1, C57.1, C72.1, C75.1, C87.1, C88.1, C96.1, C97.1, D23.2 (A), U2.1 (V+), U3.1 (V+), U5.2 (VO), U8.1 (V+), U10.1 (V+), U12.1 (V+), U15.1 (V+), U17.1 (V+), U19.1 (V+)
+5V: C44.2, C66.1, D9.6 (+Vo), D22.2 (A), D68.2 (A), D69.2 (A), D70.2 (A), D71.2 (A), U4.3 (VI), U23.A1, U24.A1, U25.A1, U26.A1
+24V: C67.1, D10.1 (A1), D19.2 (A), F1.2, F2.1, F3.1, F4.2, F5.2, F6.2, J2.1, J2.2, J2.3, J6.2, J6.4, J7.1, J8.1, J28.2, J29.2, J30.2, J31.2, J32.2, J33.2, R55.2
-24V_IN: D10.2 (A2), J6.1, J6.3, Q1.2 (D)
/A: D21.1 (K), J38.4, J39.4, L4.3
/B: D21.2 (K), J38.3, J39.3, L4.4
/CANH: D14.1 (K), J34.3, J35.3, L1.4
/CANL: D14.2 (K), J34.4, J35.4, L1.3
/CAN_RXD_MCU: D12.1 (RXD), U1.44 (PA11)
/CAN_TXD_MCU: D12.2 (TXD), U1.45 (PA12)
/ERROR_LvL1: C111.1, R93.1, U1.21 (PA5), U22.12
/ERROR_LvL1_IN: D24.2 (A), J2.4
/ERROR_LvL2: C112.1, R96.1, U1.22 (PA6), U22.14
/ERROR_LvL2_IN: D25.2 (A), J2.5
/ERROR_LvL3: C113.1, R97.1, U1.23 (PA7), U22.16
/ERROR_LvL3_IN: D26.2 (A), J2.6
/GPIO1: J3.2, U1.33 (PB12)
/GPIO2: J3.4, U1.34 (PB13)
/GPIO3: J3.6, U1.35 (PB14)
/GPIO4: J3.8, U1.36 (PB15)
/GPIO5: J3.10, U1.37 (PC6)
/GPIO6: J3.12, U1.38 (PC7)
/GPIO7: J3.14, U1.39 (PC8)
/GPIO8: J3.16, U1.40 (PC9)
/RS_RXD_MCU: D18.4 (RXD), U1.43 (PA10)
/RS_TXD_MCU: D18.3 (TXD), U1.42 (PA9)
/SWCLK: U1.49 (PA14), U14.1 (I/O1)
/SWDIO: U1.46 (PA13), U14.3 (I/O2)
/Sensor_1/P_measure_MCU: C10.1, D2.3 (common), R10.2, TP1.1 (1_1), U1.8 (PC0)
/Sensor_2/P_measure_MCU: C11.1, D3.3 (common), R17.2, TP2.1 (1_1), U1.9 (PC1)
/Sensor_3/P_measure_MCU: C41.1, D4.3 (common), R27.2, TP3.1 (1_1), U1.10 (PC2)
/Sensor_4/P_measure_MCU: C55.1, D6.3 (common), R35.2, TP4.1 (1_1), U1.11 (PC3)
/Sensor_5/P_measure_MCU: C64.1, D8.3 (common), R46.2, TP5.1 (1_1), U1.15 (PA1)
/Sensor_6/P_measure_MCU: C86.1, D13.3 (common), R61.2, TP6.1 (1_1), U1.16 (PA2)
/Sensor_flow_1/F_measure_MCU: C95.1, D15.3 (common), R69.2, TP7.1 (1_1), U1.17 (PA3)
/Sensor_flow_2/F_measure_MCU: C104.1, D16.3 (common), R77.2, TP8.1 (1_1), U1.20 (PA4)
/Solenoid1_MCU: D56.3 (common), R108.1, TP40.1 (1_1), U1.50 (PA15)
/Solenoid2_MCU: D59.3 (common), R111.1, TP41.1 (1_1), U1.51 (PC10)
/Solenoid3_MCU: D62.3 (common), R114.1, TP42.1 (1_1), U1.52 (PC11)
/Solenoid4_MCU: D65.3 (common), R117.1, TP43.1 (1_1), U1.53 (PC12)
BOOT0: R1.2, U1.60 (BOOT0)
GND: C1.2, C2.2, C3.1, C4.2, C5.1, C6.2, C7.1, C8.2, C9.2, C10.2, C11.2, C12.2, C13.2, C14.2, C15.2, C20.2, C21.2, C22.2, C23.2, C26.1, C28.2, C29.2, C30.2, C34.1, C37.2, C38.2, C40.2, C41.2, C44.1, C47.2, C48.2, C50.2, C51.2, C52.1, C54.2, C55.2, C59.2, C60.2, C61.1, C63.2, C64.2, C65.1, C66.2, C77.2, C78.2, C79.1, C81.2, C82.2, C83.2, C84.2, C85.2, C86.2, C90.2, C91.2, C92.1, C94.2, C95.2, C99.2, C100.2, C101.1, C103.2, C104.2, C105.2, C107.2, C108.2, C109.2, C110.2, C111.2, C112.2, C113.2, D2.1 (A), D3.1 (A), D4.1 (A), D6.1 (A), D8.1 (A), D9.7 (0V), D12.3 (GND), D13.1 (A), D15.1 (A), D16.1 (A), D18.2 (GND), D56.1 (A), D59.1 (A), D62.1 (A), D65.1 (A), J1.1, J3.1, J3.3, J3.5, J3.7, J3.9, J3.11, J3.13, J3.15, JP3.2 (B), JP6.2 (B), JP7.2 (B), Q10.2 (S), Q11.2 (S), Q12.2 (S), Q13.2 (S), R1.1, R5.1, R6.2, R16.1, R25.1, R33.1, R39.2, R44.1, R49.2, R57.2, R59.1, R67.1, R75.1, R87.2, R110.1, R113.1, R116.1, R119.1, TP9.1 (1_1), TP10.1 (1_1), TP11.1 (1_1), TP12.1 (1_1), TP13.1 (1_1), TP14.1 (1_1), TP15.1 (1_1), TP16.1 (1_1), TP36.1 (1_1), TP37.1 (1_1), TP38.1 (1_1), TP39.1 (1_1), U1.12 (VSSA), U1.18 (VSS), U1.63 (VSS), U2.5 (V-), U3.5 (V-), U4.1 (GND), U6.2 (V-), U7.2 (V-), U8.5 (V-), U9.2 (V-), U10.5 (V-), U11.2 (V-), U12.5 (V-), U13.2 (V-), U14.2 (GND), U15.5 (V-), U16.2 (V-), U17.5 (V-), U18.2 (V-), U19.5 (V-), U20.2 (V-), U22.11, U22.13, U22.15, Y1.2, Y1.4
GNDD: C18.2, C19.2, C24.2, C25.2, C32.2, C33.2, C35.1, C42.2, C43.2, C45.1, C56.2, C57.2, C67.2, C68.2, C69.2, C71.2, C72.2, C73.2, C74.2, C75.2, C87.2, C88.2, C96.2, C97.2, D1.1 (GND), D1.3 (0V), D9.1 (GND), D58.2 (A), D61.2 (A), D64.2 (A), D67.2 (A), J7.3, J7.4, J8.3, J8.4, J24.2, J25.2, J26.2, J27.2, Q2.2 (D), R54.2, R58.2, R79.2, R80.2, R81.2, R82.2, R83.2, R84.2, R85.2, R86.2, R109.2, R112.2, R115.2, R118.2, TP25.1 (1_1), TP26.1 (1_1), TP27.1 (1_1), TP28.1 (1_1), TP29.1 (1_1), TP30.1 (1_1), TP31.1 (1_1), TP32.1 (1_1), U2.4 (V-), U3.4 (V-), U5.1 (GND), U8.4 (V-), U10.4 (V-), U12.4 (V-), U15.4 (V-), U17.4 (V-), U19.4 (V-), U22.2, U22.4, U22.6
GND_CAN: C49.2, D12.5 (CANG), D14.3 (A), J34.1, J34.2, J35.1, J35.2
GND_RS485: C106.2, D18.10 (RGND), D21.3 (A), J38.1, J38.2, J39.1, J39.2
NRST: C65.2, R2.2, U1.7 (NRST)
unnamed: C16.2, R10.1, R21.2, U6.1
unnamed: C17.1, R9.2, U2.2 (+)
unnamed: C17.2, R7.2, U2.3 (-)
unnamed: C27.1, R12.2, U3.2 (+)
unnamed: C27.2, R13.2, U3.3 (-)
unnamed: C31.2, R17.1, R22.2, U7.1
unnamed: C36.1, R19.2, U8.2 (+)
unnamed: C36.2, R20.2, U8.3 (-)
unnamed: C39.2, R26.2, R27.1, U9.1
unnamed: C46.1, R29.2, U10.2 (+)
unnamed: C46.2, R30.2, U10.3 (-)
unnamed: C49.1, R37.1, R40.2
unnamed: C53.2, R34.2, R35.1, U11.1
unnamed: C58.1, R38.2, U12.2 (+)
unnamed: C58.2, R41.2, U12.3 (-)
unnamed: C62.2, R45.2, R46.1, U13.1
unnamed: C68.1, F2.2, L3.1
unnamed: C73.1, F3.2, L2.1
unnamed: C76.1, R51.2, U15.2 (+)
unnamed: C76.2, R52.2, U15.3 (-)
unnamed: C80.2, R60.2, R61.1, U16.1
unnamed: C89.1, R63.2, U17.2 (+)
unnamed: C89.2, R64.2, U17.3 (-)
unnamed: C93.2, R68.2, R69.1, U18.1
unnamed: C98.1, R71.2, U19.2 (+)
unnamed: C98.2, R72.2, U19.3 (-)
unnamed: C102.2, R76.2, R77.1, U20.1
unnamed: C106.1, R88.1, R89.2
unnamed: C45.2, C74.1, D1.4 (+Vo), U5.3 (VI)
unnamed: C71.1, D1.2 (Vin), L2.2
unnamed: D5.2 (A), J1.4
unnamed: D7.2 (A), U1.3 (PC14)
unnamed: D7.1 (K), R6.1
unnamed: C69.1, D9.2 (Vin), L3.2
unnamed: D11.1 (K), R39.1
unnamed: D12.7 (CANH), JP1.1 (A), L1.1
unnamed: D12.6 (CANL), JP2.2 (B), L1.2
unnamed: D17.2 (A), U1.2 (PC13)
unnamed: D17.1 (K), R87.1
unnamed: D18.9 (A), JP4.1 (A), L4.2
unnamed: D18.8 (B), JP5.2 (B), L4.1
unnamed: D19.1 (K), R54.1
unnamed: C70.2, D20.2 (A), Q1.3 (S), Q2.3 (S), R78.2
unnamed: C70.1, D20.1 (K), Q1.1 (G), Q2.1 (G), R55.1, R78.1
unnamed: D22.1 (K), R57.1
unnamed: D23.1 (K), R58.1
unnamed: D24.1 (K), R92.1
unnamed: D25.1 (K), R94.1
unnamed: D26.1 (K), R95.1
unnamed: D57.2 (A), D58.1 (K), J24.1, U23.14
unnamed: D57.1 (K), R109.1
unnamed: D60.2 (A), D61.1 (K), J25.1, U24.14
unnamed: D60.1 (K), R112.1
unnamed: D63.2 (A), D64.1 (K), J26.1, U25.14
unnamed: D63.1 (K), R115.1
unnamed: D66.2 (A), D67.1 (K), J27.1, U26.14
unnamed: D66.1 (K), R118.1
unnamed: D68.1 (K), R120.1
unnamed: D69.1 (K), R121.1
unnamed: D70.1 (K), R122.1
unnamed: D71.1 (K), R123.1
unnamed: F1.1, U23.11
unnamed: F4.1, U24.11
unnamed: F5.1, U25.11
unnamed: F6.1, U26.11
unnamed: J1.2, R48.2
unnamed: J1.3, R47.2
unnamed: J7.2, R62.1, R63.1, TP23.1 (1_1)
unnamed: J8.2, R70.1, R71.1, TP24.1 (1_1)
unnamed: J28.1, R3.1, R9.1, TP17.1 (1_1)
unnamed: J29.1, R4.1, R12.1, TP18.1 (1_1)
unnamed: J30.1, R18.1, R19.1, TP19.1 (1_1)
unnamed: J31.1, R28.1, R29.1, TP20.1 (1_1)
unnamed: J32.1, R36.1, R38.1, TP21.1 (1_1)
unnamed: J33.1, R50.1, R51.1, TP22.1 (1_1)
unnamed: JP1.2 (B), R37.2
unnamed: JP2.1 (A), R40.1
unnamed: C105.1, H2.1 (1_1), JP3.1 (A), R49.1
unnamed: JP4.2 (B), R88.2
unnamed: JP5.1 (A), R89.1
unnamed: C109.1, JP6.1 (A), R90.2, U1.26 (PB0)
unnamed: C110.1, JP7.1 (A), R91.2, U1.27 (PB1)
unnamed: Q10.3 (D), R120.2, U23.A2
unnamed: C82.1, Q10.1 (G), R108.2, R110.2
unnamed: Q11.3 (D), R121.2, U24.A2
unnamed: C83.1, Q11.1 (G), R111.2, R113.2
unnamed: Q12.3 (D), R122.2, U25.A2
unnamed: C84.1, Q12.1 (G), R114.2, R116.2
unnamed: Q13.3 (D), R123.2, U26.A2
unnamed: C85.1, Q13.1 (G), R117.2, R119.2
unnamed: R3.2, R7.1, R79.1
unnamed: R8.1, U2.7 (+)
unnamed: R11.1, U2.6 (-)
unnamed: R4.2, R13.1, R80.1
unnamed: R14.1, U3.7 (+)
unnamed: R15.1, U3.6 (-)
unnamed: R18.2, R20.1, R81.1
unnamed: R23.1, U8.7 (+)
unnamed: R24.1, U8.6 (-)
unnamed: R28.2, R30.1, R82.1
unnamed: R31.1, U10.7 (+)
unnamed: R32.1, U10.6 (-)
unnamed: R36.2, R41.1, R83.1
unnamed: R42.1, U12.7 (+)
unnamed: R43.1, U12.6 (-)
unnamed: R47.1, U14.4 (I/O2)
unnamed: R48.1, U14.6 (I/O1)
unnamed: R50.2, R52.1, R84.1
unnamed: R53.1, U15.7 (+)
unnamed: R56.1, U15.6 (-)
unnamed: R62.2, R64.1, R85.1
unnamed: R65.1, U17.7 (+)
unnamed: R66.1, U17.6 (-)
unnamed: R70.2, R72.1, R86.1
unnamed: R73.1, U19.7 (+)
unnamed: R74.1, U19.6 (-)
unnamed: R92.2, U22.5
unnamed: R94.2, U22.3
unnamed: R95.2, U22.1
unnamed: C26.2, U1.5 (PH0), Y1.3
unnamed: C30.1, U1.6 (PH1), Y1.1
unnamed: C20.1, U1.31 (VCAP_1)
unnamed: C21.1, U1.47 (VCAP_2)
unnamed: C3.2, R5.2, R8.2, U6.3 (+)
unnamed: C16.1, R11.2, R21.1, U6.4 (-)
unnamed: C5.2, R14.2, R16.2, U7.3 (+)
unnamed: C31.1, R15.2, R22.1, U7.4 (-)
unnamed: C7.2, R23.2, R25.2, U9.3 (+)
unnamed: C39.1, R24.2, R26.1, U9.4 (-)
unnamed: C52.2, R31.2, R33.2, U11.3 (+)
unnamed: C53.1, R32.2, R34.1, U11.4 (-)
unnamed: C61.2, R42.2, R44.2, U13.3 (+)
unnamed: C62.1, R43.2, R45.1, U13.4 (-)
unnamed: C79.2, R53.2, R59.2, U16.3 (+)
unnamed: C80.1, R56.2, R60.1, U16.4 (-)
unnamed: C92.2, R65.2, R67.2, U18.3 (+)
unnamed: C93.1, R66.2, R68.1, U18.4 (-)
unnamed: C101.2, R73.2, R75.2, U20.3 (+)
unnamed: C102.1, R74.2, R76.1, U20.4 (-)
