Alexandr-Filatov/Storage_Armature_MCU_PCB/(commit log)

2026-04-29 zero commit
    [0039281063.stp, 0039288040.stp, 0300700235.stp, 0353180420.stp, 039288020.stp, 1-776087-1.step, 1-776087-1_v2.stp, 2071583-4.stp]
2026-05-04 VER1.0: сделал все питание и один измерительный канал
    [0026013114.stp, B_LS-1WR3.stp, Measure.kicad_sch, Solenoid_control.kicad_sch, Storage_Armature_MCU_PCB.kicad_pcb, Storage_Armature_MCU_PCB.kicad_sch, WRB_S-3WR2.PcbLib, WRB_S-3WR2.SchLib]
2026-05-05 VER1.0: разместил все компоненты
    [MF-SM075-2.stp, Measure.kicad_sch, Storage_Armature_MCU_PCB.kicad_pcb, Storage_Armature_MCU_PCB.kicad_sch]
2026-05-05 VER1.0: развел все кроме ножек МК
    [Solenoid_control.kicad_sch, Storage_Armature_MCU_PCB.kicad_pcb, Storage_Armature_MCU_PCB.kicad_sch]
2026-05-05 VER1.0: добавил предохранители каждому клапану и отдельно по питанию
    [Measure.kicad_sch, Solenoid_control.kicad_sch, Storage_Armature_MCU_PCB.kicad_pcb, Storage_Armature_MCU_PCB.kicad_sch]
2026-05-06 VER1.0: объединил земли датчиков и 24В
    [1812_V01.STEP, Measure.kicad_sch, Storage_Armature_MCU_PCB.kicad_pcb, Storage_Armature_MCU_PCB.kicad_sch]
2026-05-07 VER1.0: добавил светодиоды, тестпоинты и мягкий старт 24В
    [Measure.kicad_sch, Solenoid_control.kicad_sch, Storage_Armature_MCU_PCB.kicad_pcb, Storage_Armature_MCU_PCB.kicad_sch]
2026-05-08 VER1.0: добавил RS485, Board ID, вырезы в плате
    [Solenoid_control.kicad_sch, Storage_Armature_MCU_PCB.kicad_pcb, Storage_Armature_MCU_PCB.kicad_sch, TD301D485H-AB.stp]
2026-05-25 VER1.0: добавил сухие контакты и логотип
    [0353180620.stp, Storage_Armature_MCU_PCB.kicad_pcb, Storage_Armature_MCU_PCB.kicad_sch]
2026-05-28 VER1.0: добавил схему в PDF
    [Storage_Armature_MCU_PCB.kicad_sch]
2026-06-01 VER1.0: добавил светодиоды аварии и гребенку для анализатора
    [Storage_Armature_MCU_PCB.kicad_pcb, Storage_Armature_MCU_PCB.kicad_sch]
2026-06-03 VER1.0: изменил структуру проекта, добавил gitignore, проверил плату на ошибки
    [Measure.kicad_sch, Power_relay_control.kicad_sch, Solenoid_control.kicad_sch, Storage_Armature_MCU_PCB.kicad_pcb, Storage_Armature_MCU_PCB.kicad_sch, Voltage_measure.kicad_sch]
2026-06-03 VER1.0: добавил BOM и гербера
    [Measure.kicad_sch, Solenoid_control.kicad_sch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]
2026-06-08 VER1.0: исправил каналы расходомеров, добавил папку с отчетным КД
    [Flow_measure.kicad_sch, Flow_meter.kicad_sch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]
2026-06-08 VER1.0: обновил гербера
    [Storage_Armature_MCU_PCB.kicad_pcb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]
2026-07-08 VER1.0: обновил шелкографию, гербера и BOM
    [Flow_measure.kicad_sch, Measure.kicad_sch, Solenoid_control.kicad_sch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]
2026-08-04 VER1.0: добавил интерактивный BOM
